kostareg/zenith/docs/v0.1.0.md

## Zenith Architecture v0.1.0

### Summary

Zenith is a 64-bit little-endian CPU coupled with a tile-based tensor accelerator. Instructions are fixed-width 32 bits, it uses a load/store architecture, and has byte-addressable memory. See below for details on registers, instructions, and traps.

### Registers

#### CPU Registers

Zenith CPU has 32 registers. They are almost all general-purpose, but have some conventions as described below. Each are one word (64 bits) and memory is little-endian. 

| zn | name  | description |
|---|---|---|
| z0 | zero  | always zero |
| z1 | ra | return address |
| z2 | sp | stack pointer |
| z3–z10  | a0–a7 | arguments / return values |
| z11–z18 | t0–t7 | caller-saved |
| z19–z26 | s0–s7 | callee-saved |
| z27–z31 | k0–k4 | kernel trap / scratch |

#### TPU Registers

The TPU has 32 registers for the tensor unit, each being 1024 bits. This can store, for example, an 8x8 16-bit tensor.

### Instructions

#### Arithmetic

| Instruction | Description |
|---|---|
| add rd, rs1, rs2 | rd = rs1 + rs2 |
| sub rd, rs1, rs2 | rd = rs1 - rs2 |
| mul rd, rs1, rs2 | rd = rs1 * rs2 |
| div rd, rs1, rs2 | rd = rs1 / rs2[^1] |
| addi rd, rs1, imm | rd = rs1 + imm |
| muli rd, rs1, imm | rd = rs1 * imm |
| divi rd, rs1, imm | rd = rs1 / imm |
| and rd, rs1, rs2 | bitwise and |
| or rd, rs1, rs2 | bitwise or |
| xor rd, rs1, rs2 | bitwise xor |
| not rd, rs1 | bitwise not |
| sll rd, rs1, rs2 | logical left shift |
| srl rd, rs1, rs2 | logical right shift |
| sla rd, rs1, rs2 | arithmetic left shift  |
| sra rd, rs1, rs2 | arithmetic right shift |

[^1]: traps on divide by zero.

Arithmetic overflow is undefined behaviour.
Shift instructions use the low 6 bits of `rs2` as the shift amount. Arithmetic left shift is equivalent to logical
left shift for 64-bit two's-complement values.

#### Memory

| Instruction | Description |
|---|---|
| l8  rd, imm(rs1) | load 8-bit value, sign-extend to 64-bit |
| l16 rd, imm(rs1) | load 16-bit value, sign-extend to 64-bit |
| l32 rd, imm(rs1) | load 32-bit value, sign-extend to 64-bit |
| l64 rd, imm(rs1) | load 64-bit value |
| s8  rs2, imm(rs1)  | store lower 8 bits of rs2 |
| s16 rs2, imm(rs1)  | store lower 16 bits of rs2 |
| s32 rs2, imm(rs1)  | store lower 32 bits of rs2 |
| s64 rs2, imm(rs1)  | store full 64 bits of rs2 |
| tld qd, imm(rs1) | load tensor |
| tsd qs, imm(rs1) | store tensor |

#### Control

| Instruction | Description |
|---|---|
| beq rs1, rs2, off | branch if equal |
| bne rs1, rs2, off | branch if not equal |
| bge rs1, rs2, off | branch if >= |
| ble rs1, rs2, off | branch if <= |
| bgt rs1, rs2, off | branch if > |
| blt rs1, rs2, off | branch if < |
| jal rd, off | rd = next pc; jump |
| jalr rd, rs1, off | rd = next pc; indirect jump |

Branch offsets are signed relative immediate values. Regular execution advances the program counter by 4 bytes (32
bits).

#### Tensor

| Instruction | Description |
|---|---|
| tmatmul qd, qa, qb | qd = qa * qb (matrix-wise) |
| tmul qd, qa, qb | qd = qa * qb (element-wise) |
| tmac qd, qa, qb | qd += qa * qb |
| tadd qd, qa, qb | qd = qa + qb |
| tsub qd, qa, qb | qd = qa - qb |
| tmov qd, qs | copy |
| tfill qd, imm | fill |
| tscale qd, qs, imm | shift / scale |
| tmax rd, qs | max reduction |
| targmax rd, qs | index of max element |
| tsum rd, qs | sum reduction |
| tcast qd, rs | broadcast scalar |
| tsync | sync |

#### System

| Instruction | Description |
|---|---|
| ecall | trap to kernel |
| eret | return from trap |
| halt | stop execution |

#### Instruction Encoding

All Zenith instructions are encoded as 32-bit little-endian words. The low 7 bits select the opcode.

| Bits  | Name | Description |
|---|---|---|
| 0–6 | opcode  | instruction opcode |
| 7–11  | field1  | first register field |
| 12–16 | field2  | second register field |
| 17–21 | field3  | third register field |
| 22–31 | unused  | reserved |

Register-register instructions use `field1` as `rd`, `field2` as `rs1`, and `field3` as `rs2`.

| Bits  | Name |
|---|---|
| 0–6 | opcode |
| 7–11  | rd |
| 12–16 | rs1 |
| 17–21 | rs2 |
| 22–31 | unused |

Unary register instructions use `field1` as `rd`, `field2` as `rs1`, and reserve `field3` and unused bits as zero.

| Bits  | Name |
|---|---|
| 0–6 | opcode |
| 7–11  | rd |
| 12–16 | rs1 |
| 17–21 | reserved |
| 22–31 | reserved |

Register-immediate, load, store, branch, and `jalr` instructions use a 15-bit signed immediate in bits 17–31.

| Bits  | Name |
|---|---|
| 0–6 | opcode |
| 7–11  | rd/rs1/rs2 |
| 12–16 | rs1/rs2 |
| 17–31 | imm15 / off15  |

For arithmetic-immediate and load instructions, `field1` is `rd` and `field2` is `rs1`. For store instructions,
`field1` is `rs2` and `field2` is `rs1`. For branch instructions, `field1` is `rs1`, `field2` is `rs2`, and the
signed offset is relative to the current program counter. For `jalr`, `field1` is `rd`, `field2` is `rs1`, and the
signed offset is relative to `rs1`.

`jal` uses a 20-bit signed offset in bits 12–31.

| Bits  | Name  |
|---|---|
| 0–6 | opcode |
| 7–11  | rd |
| 12–31 | off20 |

Assigned opcodes:

| Opcode | Instruction |
|---|---|
| 0x00 | add |
| 0x01 | sub |
| 0x02 | mul |
| 0x03 | div |
| 0x04 | addi |
| 0x05 | muli |
| 0x06 | divi |
| 0x07 | and |
| 0x08 | or |
| 0x09 | xor |
| 0x0A | l8 |
| 0x0B | l16 |
| 0x0C | l32 |
| 0x0D | l64 |
| 0x0E | s8 |
| 0x0F | s16 |
| 0x10 | s32 |
| 0x11 | s64 |
| 0x14 | beq |
| 0x15 | bne |
| 0x16 | bge |
| 0x17 | ble |
| 0x18 | bgt |
| 0x19 | blt |
| 0x1A | jal |
| 0x1B | jalr |
| 0x1C | not |
| 0x1D | sll |
| 0x1E | srl |
| 0x1F | sla |
| 0x20 | sra |

Tensor and system opcode assignments are reserved for future revisions.

### Modes

For my future reference:

* CPU boots in kernel mode
* Kernel launches programs in user mode
* User cannot access privileged resources directly
* Uses ECALL to request kernel services

### Zelf Executable Format

Zelf is the Zenith executable format. It is a small little-endian binary format with a fixed header, one constant data
section, and one code section.

#### Header

| Offset | Size | Field | Description |
|---|---|---|---|
| 0 | 4 | magic | ASCII bytes `ZELF` |
| 4 | 1 | name_len | program name length, 0 through 8 |
| 5 | 3 | reserved | must be zero |
| 8 | 8 | name | program name, zero-padded ASCII |
| 16 | 8 | data_size | constant data section length, bytes |
| 24 | 8 | code_size | code section length, bytes |
| 32 | 8 | entry_off | entry point offset within the code section |

The header is 40 bytes. `data_size`, `code_size`, and `entry_off` are unsigned 64-bit little-endian values.

The `name` field is a short executable name stored directly in the header. It is not the filesystem path. If `name_len`
is less than 8, all remaining bytes in `name` must be zero.

#### Sections

The constant data section starts immediately after the header. The code section starts immediately after the data
section.

```text
+------------------+
| Zelf header      |
+------------------+
| constant data    |
+------------------+
| code             |
+------------------+
```

The code section contains raw 32-bit Zenith instructions. `code_size` must be a multiple of 4. `entry_off` must be a
multiple of 4 and must be less than `code_size`.

When a Zelf executable is loaded, the kernel copies the constant data and code sections into memory, and starts the
child at `code_base + entry_off`. The exact load addresses are chosen by the kernel.

### System Calls

System calls are requested with `ecall`. The syscall number is passed in `a7`. Arguments are passed in `a0` through
`a5`. Return values are passed in `a0` and `a1`.

`ecall` traps to the kernel. For system calls, the saved exception PC points to the instruction after `ecall`, so a
successful return resumes normal execution at the next instruction.

#### SYS_RUN

`SYS_RUN` loads a Zelf executable from the filesystem, runs it as a child program, and returns to the caller when that
program stops.

| Register | Input |
|---|---|
| a7 | syscall number: `1` |
| a0 | path address |
| a1 | path length, bytes |
| a2 | argument block address |
| a3 | argument block length, bytes |

| Register | Output |
|---|---|
| a0 | child exit code or error code |
| a1 | child trap cause |

The path is an opaque byte string in the caller's memory. It is not null-terminated. If `a1` is zero, the syscall
fails. The kernel copies the path before reading from the filesystem.

The file at the requested path must be a valid Zelf executable. The kernel verifies the Zelf magic number before
starting the child.

The argument block is an opaque byte range in the caller's memory. If `a3` is zero, `a2` is ignored and no arguments
are passed. If `a3` is nonzero, the kernel copies `a3` bytes starting at `a2` before the child starts. The child
receives the copied argument block at an address chosen by the kernel.

`SYS_RUN` is blocking. The caller is suspended while the child runs. When the child stops, the kernel restores the
caller and resumes after the original `ecall`.

The child starts with:

* `pc` set to the child program entry point
* `sp` set to the top of a fresh child stack
* `a0` set to the child argument block address, or zero if no arguments were passed
* `a1` set to the child argument block length
* `a2` set to the constant data section address
* `a3` set to the constant data section length
* all other general-purpose registers set to zero

The child exits normally by executing `halt`. On normal exit, the child's final `a0` value becomes the caller's return
value in `a0`, and the caller's `a1` is set to zero.

If `SYS_RUN` fails before the child starts, the caller resumes immediately with a negative error code in `a0` and zero
in `a1`.

| Error | Meaning |
|---|---|
| -1 | invalid path address or length  |
| -2 | filesystem entry not found |
| -3 | filesystem entry is not a file  |
| -4 | invalid Zelf executable |
| -5 | invalid argument block address  |
| -6 | argument block is too large |
| -7 | insufficient memory |
| -8 | child program could not start |

If the child traps instead of exiting normally, the caller resumes with `a0` set to `-9` and `a1` set to the child trap
cause. Trap cause values are defined by the trap specification.

Unless otherwise specified by the kernel ABI, `SYS_RUN` preserves the caller's registers except for `a0`, `a1`, and
kernel scratch registers.

### Memory Map

Zenith v0.1.0 defines the following physical address map:

| Address range | Region | Description |
|---|---|---|
| `0x0000_0000_0000_0000` - `0x0000_0000_3FFF_FFFF` | RAM | 1 GiB of main memory |
| `0x0000_0000_4000_0000` - `0xFFFF_FFFF_EFFF_FFFF` | reserved | reserved for future use |
| `0xFFFF_FFFF_F000_0000` - `0xFFFF_FFFF_FFFF_FFFF` | MMIO | memory-mapped I/O devices |

Accesses to reserved address ranges trap. MMIO addresses are device-defined and are not normal RAM.

### Framebuffer Controller

The framebuffer peripheral exposes a single-buffered framebuffer. It is located within the MMIO range defined by the
architecture memory map.

All framebuffer registers are little-endian 32-bit MMIO registers.

#### Memory Map

The v0.1.0 framebuffer device uses the following MMIO address ranges:

| Address range | Region | Description |
|---|---|---|
| `0xFFFF_FFFF_FFA0_1400` - `0xFFFF_FFFF_FFA1_13FF` | control | framebuffer control and status registers |
| `0xFFFF_FFFF_FFA1_1400` - `0xFFFF_FFFF_FFFF_FFFF` | pixel buffer  | 1920 x 1080 x 24-bit single framebuffer |

#### Display Format

The framebuffer is a fixed 1920 x 1080 linear image. Each pixel is 24 bits and stored in row-major order.

Pixel byte layout:

| Byte offset | Channel |
|---|---|
| 0 | red |
| 1 | green |
| 2 | blue |

The byte address for a pixel is:

```text
pixel_address = 0xFFFF_FFFF_FFA1_1400 + ((y * 1920) + x) * 3
```

where `x` is in the range 0 through 1919 and `y` is in the range 0 through 1079.

#### Registers

The control region contains a small pixel buffer controller. It exposes the framebuffer resolution and a combined
status/control register. Since this version of the framebuffer is single-buffered, there is no buffer swapping logic.

| Address | Name | Access | Description |
|---|---|---|---|
| `0xFFFF_FFFF_FFA0_1400` | `RESOLUTION` | R | framebuffer width and height |
| `0xFFFF_FFFF_FFA0_1404` | `STATUS_CONTROL` | R/W | display status when read, display control when written |

##### RESOLUTION

| Bits  | Name | Description |
|---|---|---|
| 0-15  | `WIDTH`  | framebuffer width, always 1920 |
| 16-31 | `HEIGHT` | framebuffer height, always 1080 |

##### STATUS_CONTROL

When read, `STATUS_CONTROL` returns display status:

| Bit | Name | Description |
|-----|---|---|
| 0 | `VSYNC`  | set to 1 during the vertical synchronization interval |
| 1 | `ENABLE` | set to 1 when the framebuffer output is enabled |
| 2-31| reserved | read as zero |

When written, `STATUS_CONTROL` updates display control:

| Bit | Name | Description |
|-----|---|---|
| 0 | reserved | must be written as zero |
| 1 | `ENABLE` | write 1 to enable framebuffer output, or 0 to disable it |
| 2-31| reserved | must be written as zero |

Software can poll the `VSYNC` bit to synchronize framebuffer writes with display refresh. The `VSYNC` bit is not
latched; it reflects the current display timing state.

#### Single-Buffered Behavior

The pixel buffer is single-buffered. Writes to the pixel buffer update the only framebuffer image. The display may read
from the same buffer while software is writing to it, so tearing is possible.

Software that wants to reduce tearing should update the framebuffer while the `VSYNC` bit is set.

### Keyboard Controller

The keyboard peripheral exposes a pollable key-event FIFO. Software reads key events from MMIO registers.

The hardware controller is responsible for receiving keyboard protocol data, translating it into key events, and
pushing those events into the FIFO.

All keyboard registers are little-endian 32-bit MMIO registers.

#### Memory Map

The v0.1.0 keyboard device uses the following MMIO address range:

| Address range | Region  | Description |
|---|---|---|
| `0xFFFF_FFFF_FFA0_0000` - `0xFFFF_FFFF_FFA0_0FFF` | control | keyboard control, status, and event registers |

#### Registers

| Address | Name | Access | Description |
|---|---|---|---|
| `0xFFFF_FFFF_FFA0_0000` | `STATUS_CONTROL` | R/W | keyboard status when read, keyboard control when written |
| `0xFFFF_FFFF_FFA0_0004` | `KEY_EVENT` | R | read and pop the oldest pending key event |
| `0xFFFF_FFFF_FFA0_0008` | `FIFO_COUNT` | R | number of pending key events |

##### STATUS_CONTROL

When read, `STATUS_CONTROL` returns keyboard status:

| Bit | Name | Description |
|-----|---|---|
| 0 | `READY` | set to 1 when `KEY_EVENT` can be read |
| 1 | `FULL` | set to 1 when the event FIFO is full |
| 2 | `OVERFLOW` | set to 1 if one or more key events were dropped |
| 3 | `ENABLED`  | set to 1 when the keyboard controller is enabled |
| 4-31| reserved | read as zero |

When written, `STATUS_CONTROL` updates keyboard control:

| Bit | Name | Description |
|-----|---|---|
| 0 | reserved | must be written as zero |
| 1 | reserved | must be written as zero |
| 2 | `CLR_OVER` | write 1 to clear `OVERFLOW` |
| 3 | `ENABLE` | write 1 to enable the keyboard controller, or 0 to disable it |
| 4 | `CLR_FIFO` | write 1 to discard all pending key events |
| 5-31| reserved | must be written as zero |

Disabling the keyboard controller stops new events from being pushed into the FIFO. It does not clear pending events
unless `CLR_FIFO` is also written.

##### KEY_EVENT

Reading `KEY_EVENT` returns and removes the oldest pending event from the FIFO. If `READY` is zero, reading `KEY_EVENT`
returns zero and does not change controller state.

| Bits  | Name | Description |
|---|---|---|
| 0-15  | `KEY_CODE` | key code |
| 16 | `PRESSED`  | 1 for key press, 0 for key release |
| 17 | `REPEAT` | 1 if the event is an auto-repeat key press |
| 18-31 | reserved | read as zero |

Key codes are USB HID Keyboard/Keypad usage IDs. For example, `0x04` is `A`, `0x05` is `B`, `0x1E` is `1`, `0x28` is
Enter, and `0x2C` is Space.

##### FIFO_COUNT

`FIFO_COUNT` returns the number of pending key events in the FIFO. The v0.1.0 FIFO depth is 16 events.

#### Polling

Software can poll for keyboard input by repeatedly reading `STATUS_CONTROL`. When `READY` is set, software reads
`KEY_EVENT` to consume the next key event.

```text
status = load32(0xFFFF_FFFF_FFA0_0000)
if status & 1:
    event = load32(0xFFFF_FFFF_FFA0_0004)
```
