kostareg/zenith/zenith-pcba/imports/K4B4G1646E-BCNB/BGA96_K4B4G1_SAM.step

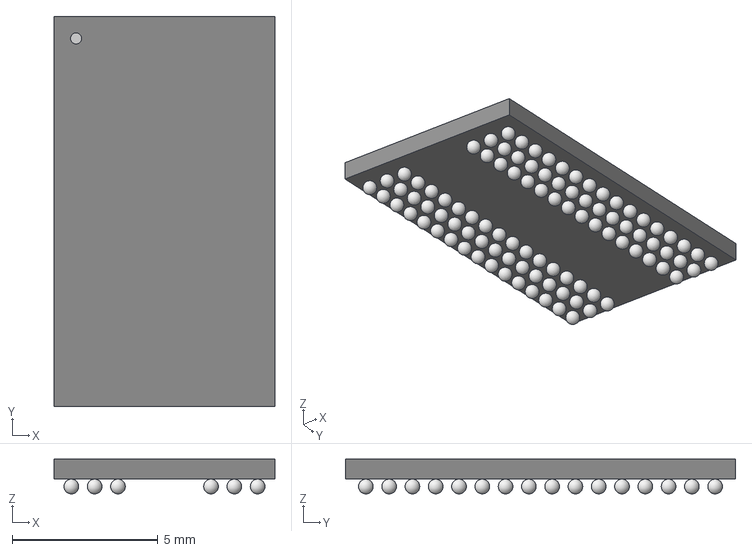
[picture p1: CAD file, 2026-07-13]
zenith-pcba/imports/K4B4G1646E-BCNB/BGA96_K4B4G1_SAM.step
7.59 x 13.4 x 1.20 mm
