kostareg/zenith/zenith-pcba/imports/XC7A50T-2CSG325C/CSCSG325_AMD.step

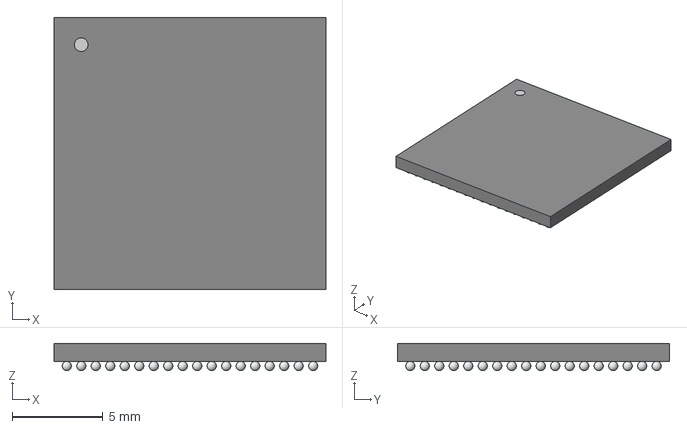
[picture p2: CAD file, 2026-07-13]
zenith-pcba/imports/XC7A50T-2CSG325C/CSCSG325_AMD.step
15.0 x 15.0 x 1.50 mm
