kostareg/zenith/zenith-pcba/zenith-pcba.kicad_pcb

## KiCad design zenith-pcba/zenith-pcba.kicad_pcb (2026-08-18)

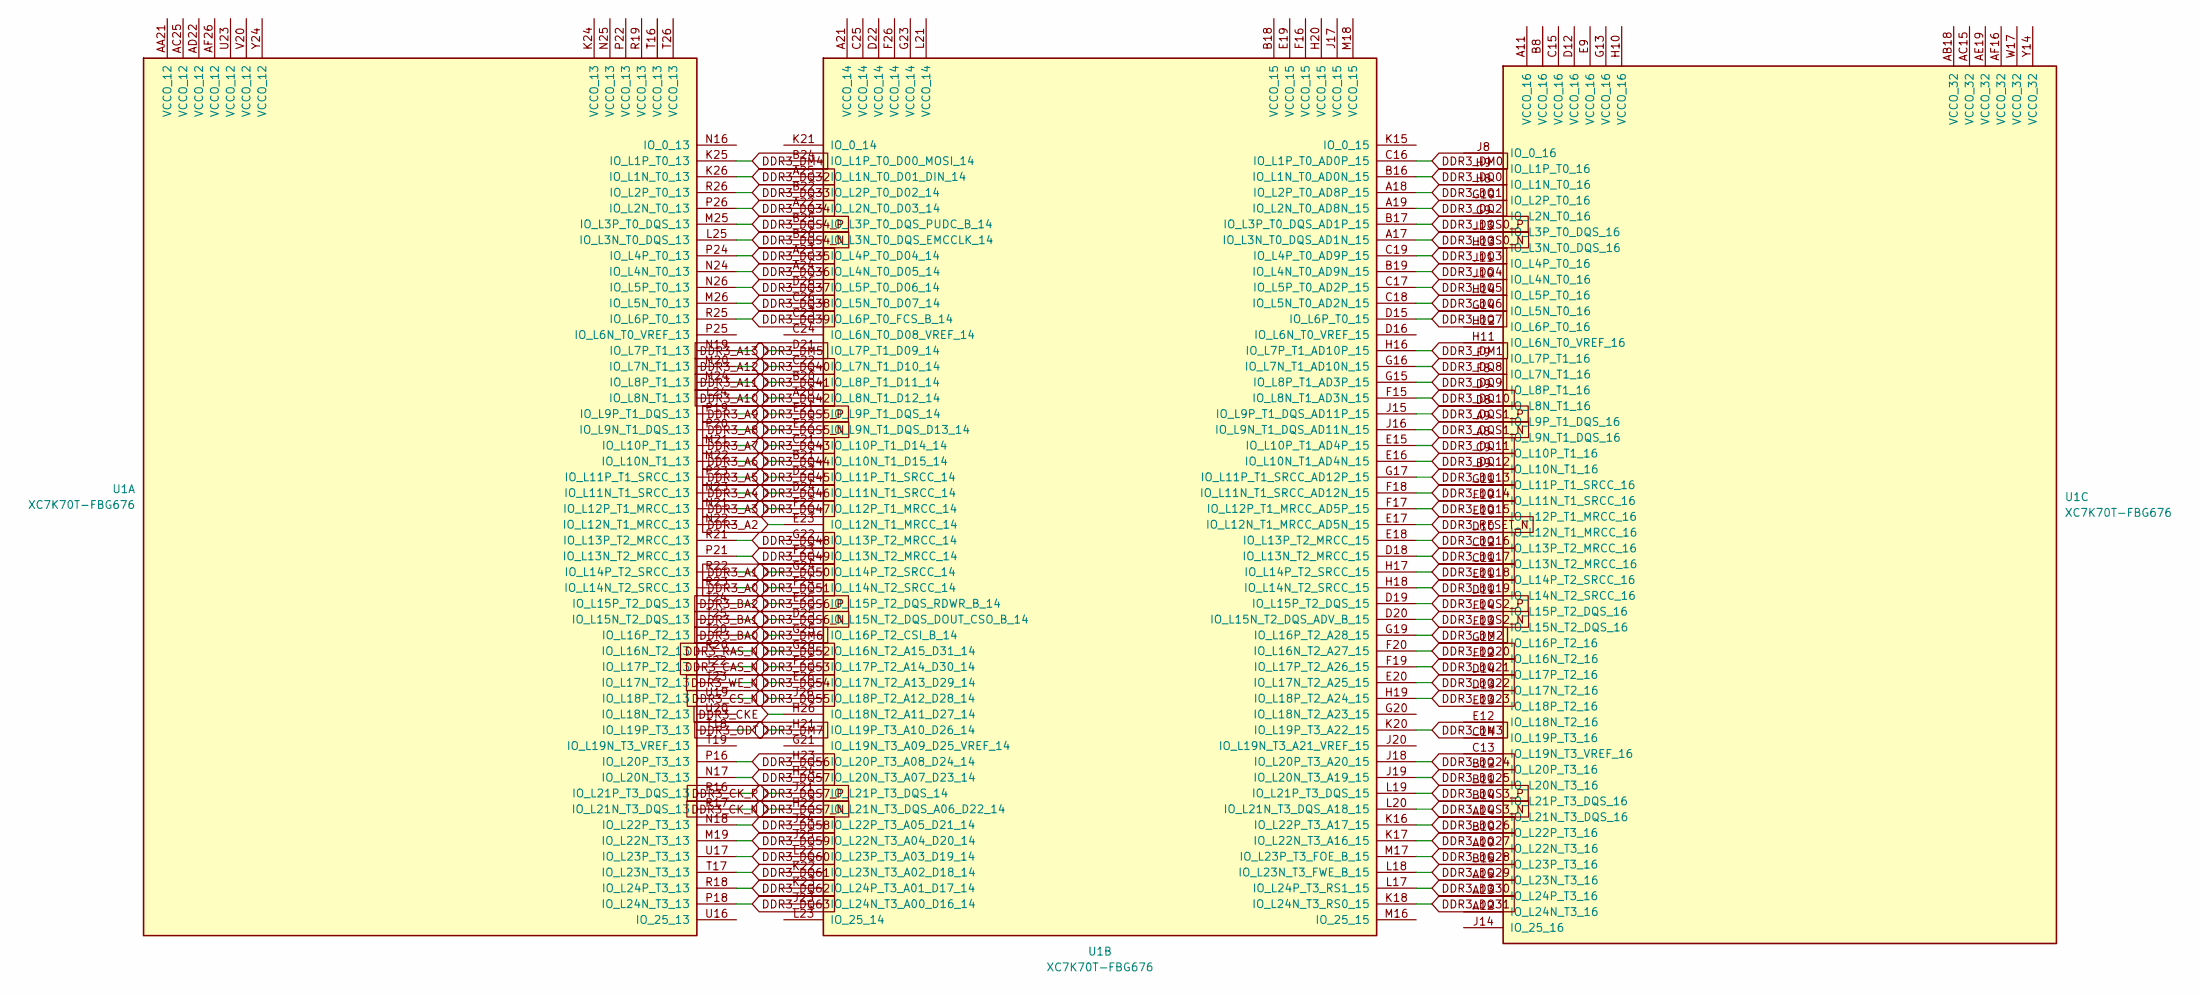
[picture p3: schematic disconnected_io.kicad_sch]

Parts:
U1: XC7K70T-FBG676; FBGA-676_L27.0-W27.0-R26-C26-P1.00-BL

Connections:
DDR3_A0: U1.F24 (IO_L14N_T2_SRCC_14); also elsewhere on the board
DDR3_A1: U1.G24 (IO_L14P_T2_SRCC_14); also elsewhere on the board
DDR3_A2: U1.E23 (IO_L12N_T1_MRCC_14); also elsewhere on the board
DDR3_A3: U1.F22 (IO_L12P_T1_MRCC_14); also elsewhere on the board
DDR3_A4: U1.D24 (IO_L11N_T1_SRCC_14); also elsewhere on the board
DDR3_A5: U1.D23 (IO_L11P_T1_SRCC_14); also elsewhere on the board
DDR3_A6: U1.B21 (IO_L10N_T1_D15_14); also elsewhere on the board
DDR3_A7: U1.C21 (IO_L10P_T1_D14_14); also elsewhere on the board
DDR3_A8: U1.E22 (IO_L9N_T1_DQS_D13_14); also elsewhere on the board
DDR3_A9: U1.E21 (IO_L9P_T1_DQS_14); also elsewhere on the board
DDR3_A10: U1.A20 (IO_L8N_T1_D12_14); also elsewhere on the board
DDR3_A11: U1.B20 (IO_L8P_T1_D11_14); also elsewhere on the board
DDR3_A12: U1.C22 (IO_L7N_T1_D10_14); also elsewhere on the board
DDR3_A13: U1.D21 (IO_L7P_T1_D09_14); also elsewhere on the board
DDR3_BA0: U1.G25 (IO_L16P_T2_CSI_B_14); also elsewhere on the board
DDR3_BA1: U1.D25 (IO_L15N_T2_DQS_DOUT_CSO_B_14); also elsewhere on the board
DDR3_BA2: U1.E25 (IO_L15P_T2_DQS_RDWR_B_14); also elsewhere on the board
DDR3_CAS_N: U1.F25 (IO_L17P_T2_A14_D30_14); also elsewhere on the board
DDR3_CKE: U1.H26 (IO_L18N_T2_A11_D27_14); also elsewhere on the board
DDR3_CK_N: U1.H22 (IO_L21N_T3_DQS_A06_D22_14); also elsewhere on the board
DDR3_CK_P: U1.J21 (IO_L21P_T3_DQS_14); also elsewhere on the board
DDR3_CS_N: U1.J26 (IO_L18P_T2_A12_D28_14); also elsewhere on the board
DDR3_DM0: U1.C16 (IO_L1P_T0_AD0P_15); also elsewhere on the board
DDR3_DM1: U1.H16 (IO_L7P_T1_AD10P_15); also elsewhere on the board
DDR3_DM2: U1.G19 (IO_L16P_T2_A28_15); also elsewhere on the board
DDR3_DM3: U1.K20 (IO_L19P_T3_A22_15); also elsewhere on the board
DDR3_DM4: U1.K25 (IO_L1P_T0_13); also elsewhere on the board
DDR3_DM5: U1.N19 (IO_L7P_T1_13); also elsewhere on the board
DDR3_DM6: U1.T20 (IO_L16P_T2_13); also elsewhere on the board
DDR3_DM7: U1.T18 (IO_L19P_T3_13); also elsewhere on the board
DDR3_DQ0: U1.B16 (IO_L1N_T0_AD0N_15); also elsewhere on the board
DDR3_DQ1: U1.A18 (IO_L2P_T0_AD8P_15); also elsewhere on the board
DDR3_DQ2: U1.A19 (IO_L2N_T0_AD8N_15); also elsewhere on the board
DDR3_DQ3: U1.C19 (IO_L4P_T0_AD9P_15); also elsewhere on the board
DDR3_DQ4: U1.B19 (IO_L4N_T0_AD9N_15); also elsewhere on the board
DDR3_DQ5: U1.C17 (IO_L5P_T0_AD2P_15); also elsewhere on the board
DDR3_DQ6: U1.C18 (IO_L5N_T0_AD2N_15); also elsewhere on the board
DDR3_DQ7: U1.D15 (IO_L6P_T0_15); also elsewhere on the board
DDR3_DQ8: U1.G16 (IO_L7N_T1_AD10N_15); also elsewhere on the board
DDR3_DQ9: U1.G15 (IO_L8P_T1_AD3P_15); also elsewhere on the board
DDR3_DQ10: U1.F15 (IO_L8N_T1_AD3N_15); also elsewhere on the board
DDR3_DQ11: U1.E15 (IO_L10P_T1_AD4P_15); also elsewhere on the board
DDR3_DQ12: U1.E16 (IO_L10N_T1_AD4N_15); also elsewhere on the board
DDR3_DQ13: U1.G17 (IO_L11P_T1_SRCC_AD12P_15); also elsewhere on the board
DDR3_DQ14: U1.F18 (IO_L11N_T1_SRCC_AD12N_15); also elsewhere on the board
DDR3_DQ15: U1.F17 (IO_L12P_T1_MRCC_AD5P_15); also elsewhere on the board
DDR3_DQ16: U1.E18 (IO_L13P_T2_MRCC_15); also elsewhere on the board
DDR3_DQ17: U1.D18 (IO_L13N_T2_MRCC_15); also elsewhere on the board
DDR3_DQ18: U1.H17 (IO_L14P_T2_SRCC_15); also elsewhere on the board
DDR3_DQ19: U1.H18 (IO_L14N_T2_SRCC_15); also elsewhere on the board
DDR3_DQ20: U1.F20 (IO_L16N_T2_A27_15); also elsewhere on the board
DDR3_DQ21: U1.F19 (IO_L17P_T2_A26_15); also elsewhere on the board
DDR3_DQ22: U1.E20 (IO_L17N_T2_A25_15); also elsewhere on the board
DDR3_DQ23: U1.H19 (IO_L18P_T2_A24_15); also elsewhere on the board
DDR3_DQ24: U1.J18 (IO_L20P_T3_A20_15); also elsewhere on the board
DDR3_DQ25: U1.J19 (IO_L20N_T3_A19_15); also elsewhere on the board
DDR3_DQ26: U1.K16 (IO_L22P_T3_A17_15); also elsewhere on the board
DDR3_DQ27: U1.K17 (IO_L22N_T3_A16_15); also elsewhere on the board
DDR3_DQ28: U1.M17 (IO_L23P_T3_FOE_B_15); also elsewhere on the board
DDR3_DQ29: U1.L18 (IO_L23N_T3_FWE_B_15); also elsewhere on the board
DDR3_DQ30: U1.L17 (IO_L24P_T3_RS1_15); also elsewhere on the board
DDR3_DQ31: U1.K18 (IO_L24N_T3_RS0_15); also elsewhere on the board
DDR3_DQ32: U1.K26 (IO_L1N_T0_13); also elsewhere on the board
DDR3_DQ33: U1.R26 (IO_L2P_T0_13); also elsewhere on the board
DDR3_DQ34: U1.P26 (IO_L2N_T0_13); also elsewhere on the board
DDR3_DQ35: U1.P24 (IO_L4P_T0_13); also elsewhere on the board
DDR3_DQ36: U1.N24 (IO_L4N_T0_13); also elsewhere on the board
DDR3_DQ37: U1.N26 (IO_L5P_T0_13); also elsewhere on the board
DDR3_DQ38: U1.M26 (IO_L5N_T0_13); also elsewhere on the board
DDR3_DQ39: U1.R25 (IO_L6P_T0_13); also elsewhere on the board
DDR3_DQ40: U1.M20 (IO_L7N_T1_13); also elsewhere on the board
DDR3_DQ41: U1.M24 (IO_L8P_T1_13); also elsewhere on the board
DDR3_DQ42: U1.L24 (IO_L8N_T1_13); also elsewhere on the board
DDR3_DQ43: U1.M21 (IO_L10P_T1_13); also elsewhere on the board
DDR3_DQ44: U1.M22 (IO_L10N_T1_13); also elsewhere on the board
DDR3_DQ45: U1.P23 (IO_L11P_T1_SRCC_13); also elsewhere on the board
DDR3_DQ46: U1.N23 (IO_L11N_T1_SRCC_13); also elsewhere on the board
DDR3_DQ47: U1.N21 (IO_L12P_T1_MRCC_13); also elsewhere on the board
DDR3_DQ48: U1.R21 (IO_L13P_T2_MRCC_13); also elsewhere on the board
DDR3_DQ49: U1.P21 (IO_L13N_T2_MRCC_13); also elsewhere on the board
DDR3_DQ50: U1.R22 (IO_L14P_T2_SRCC_13); also elsewhere on the board
DDR3_DQ51: U1.R23 (IO_L14N_T2_SRCC_13); also elsewhere on the board
DDR3_DQ52: U1.R20 (IO_L16N_T2_13); also elsewhere on the board
DDR3_DQ53: U1.T22 (IO_L17P_T2_13); also elsewhere on the board
DDR3_DQ54: U1.T23 (IO_L17N_T2_13); also elsewhere on the board
DDR3_DQ55: U1.U19 (IO_L18P_T2_13); also elsewhere on the board
DDR3_DQ56: U1.P16 (IO_L20P_T3_13); also elsewhere on the board
DDR3_DQ57: U1.N17 (IO_L20N_T3_13); also elsewhere on the board
DDR3_DQ58: U1.N18 (IO_L22P_T3_13); also elsewhere on the board
DDR3_DQ59: U1.M19 (IO_L22N_T3_13); also elsewhere on the board
DDR3_DQ60: U1.U17 (IO_L23P_T3_13); also elsewhere on the board
DDR3_DQ61: U1.T17 (IO_L23N_T3_13); also elsewhere on the board
DDR3_DQ62: U1.R18 (IO_L24P_T3_13); also elsewhere on the board
DDR3_DQ63: U1.P18 (IO_L24N_T3_13); also elsewhere on the board
DDR3_DQS0_N: U1.A17 (IO_L3N_T0_DQS_AD1N_15); also elsewhere on the board
DDR3_DQS0_P: U1.B17 (IO_L3P_T0_DQS_AD1P_15); also elsewhere on the board
DDR3_DQS1_N: U1.J16 (IO_L9N_T1_DQS_AD11N_15); also elsewhere on the board
DDR3_DQS1_P: U1.J15 (IO_L9P_T1_DQS_AD11P_15); also elsewhere on the board
DDR3_DQS2_N: U1.D20 (IO_L15N_T2_DQS_ADV_B_15); also elsewhere on the board
DDR3_DQS2_P: U1.D19 (IO_L15P_T2_DQS_15); also elsewhere on the board
DDR3_DQS3_N: U1.L20 (IO_L21N_T3_DQS_A18_15); also elsewhere on the board
DDR3_DQS3_P: U1.L19 (IO_L21P_T3_DQS_15); also elsewhere on the board
DDR3_DQS4_N: U1.L25 (IO_L3N_T0_DQS_13); also elsewhere on the board
DDR3_DQS4_P: U1.M25 (IO_L3P_T0_DQS_13); also elsewhere on the board
DDR3_DQS5_N: U1.P20 (IO_L9N_T1_DQS_13); also elsewhere on the board
DDR3_DQS5_P: U1.P19 (IO_L9P_T1_DQS_13); also elsewhere on the board
DDR3_DQS6_N: U1.T25 (IO_L15N_T2_DQS_13); also elsewhere on the board
DDR3_DQS6_P: U1.T24 (IO_L15P_T2_DQS_13); also elsewhere on the board
DDR3_DQS7_N: U1.R17 (IO_L21N_T3_DQS_13); also elsewhere on the board
DDR3_DQS7_P: U1.R16 (IO_L21P_T3_DQS_13); also elsewhere on the board
DDR3_ODT: U1.H21 (IO_L19P_T3_A10_D26_14); also elsewhere on the board
DDR3_RAS_N: U1.G26 (IO_L16N_T2_A15_D31_14); also elsewhere on the board
DDR3_RESET_N: U1.E17 (IO_L12N_T1_MRCC_AD5N_15); also elsewhere on the board
DDR3_WE_N: U1.E26 (IO_L17N_T2_A13_D29_14); also elsewhere on the board

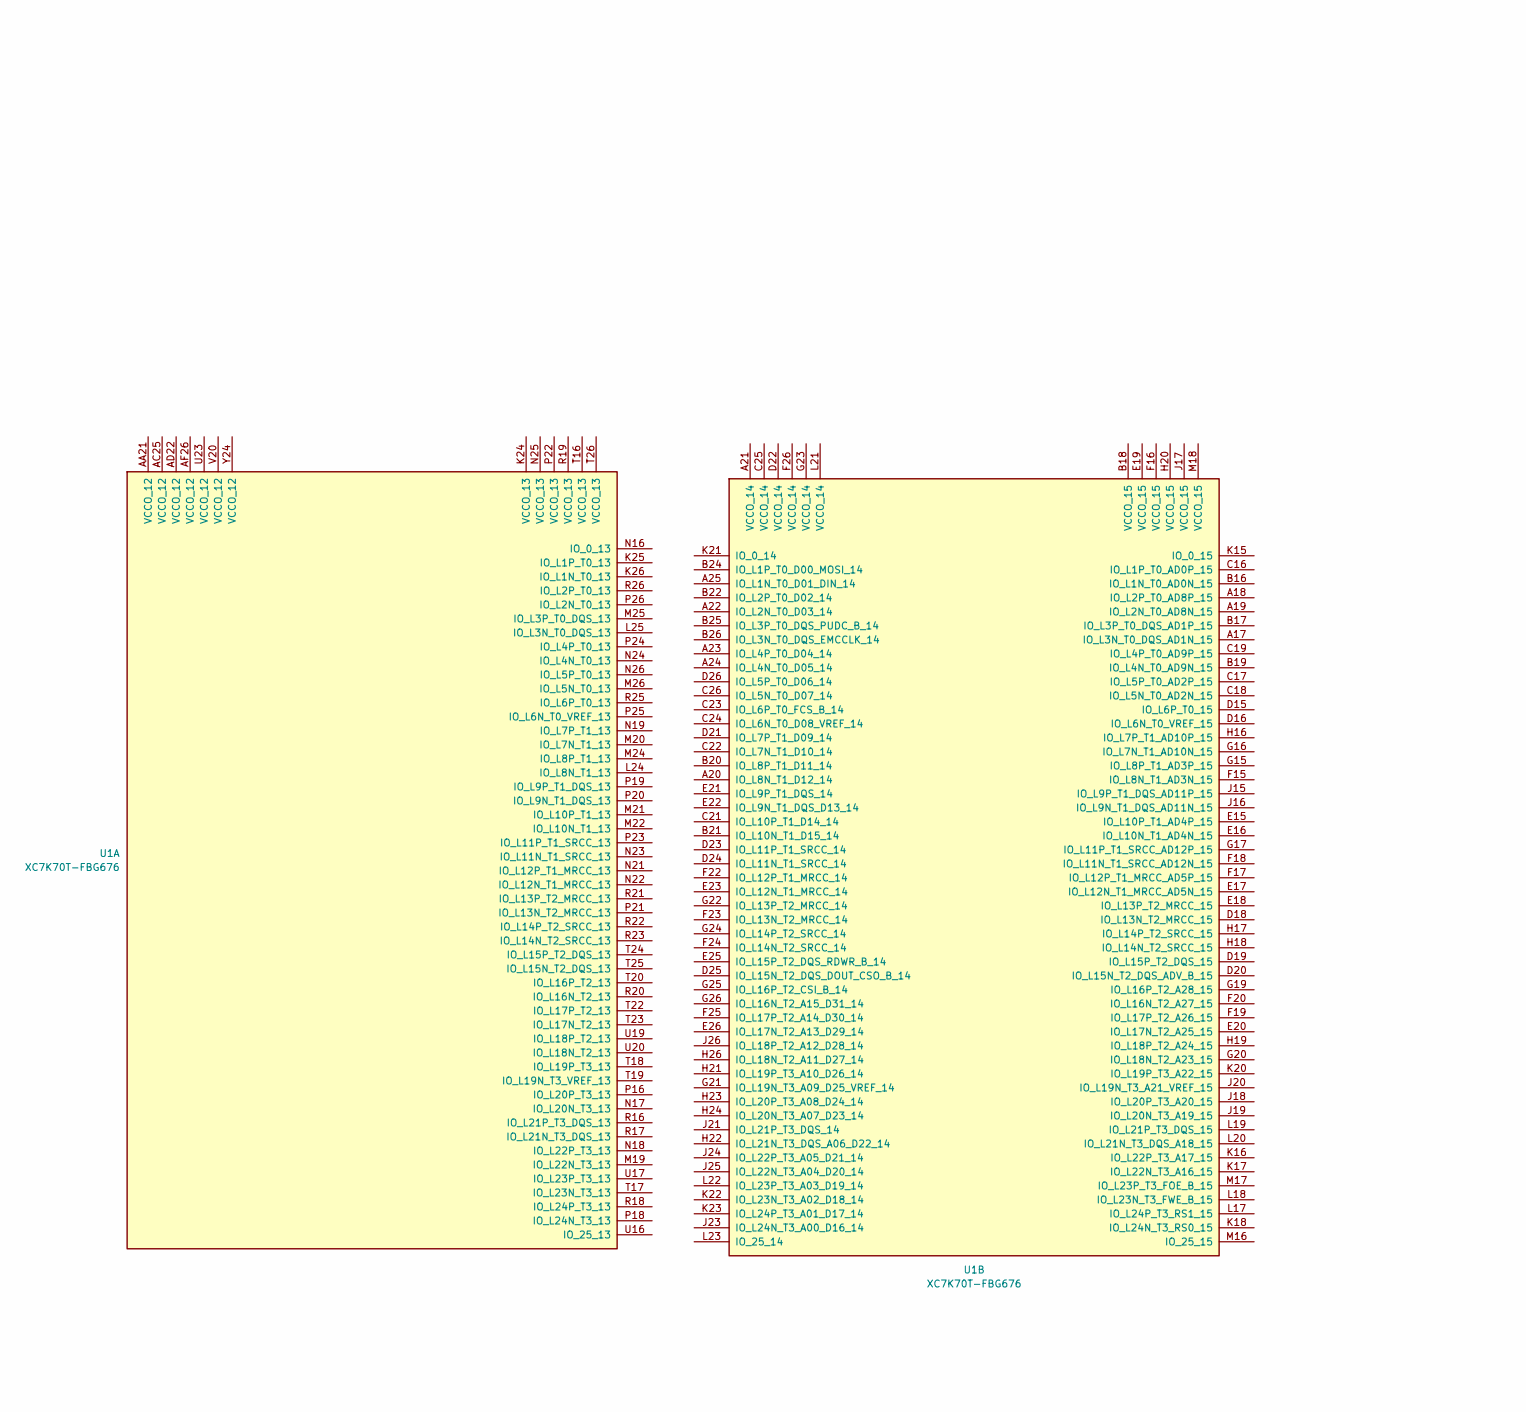
[picture p4: schematic other.kicad_sch, part in row 1, column 1]

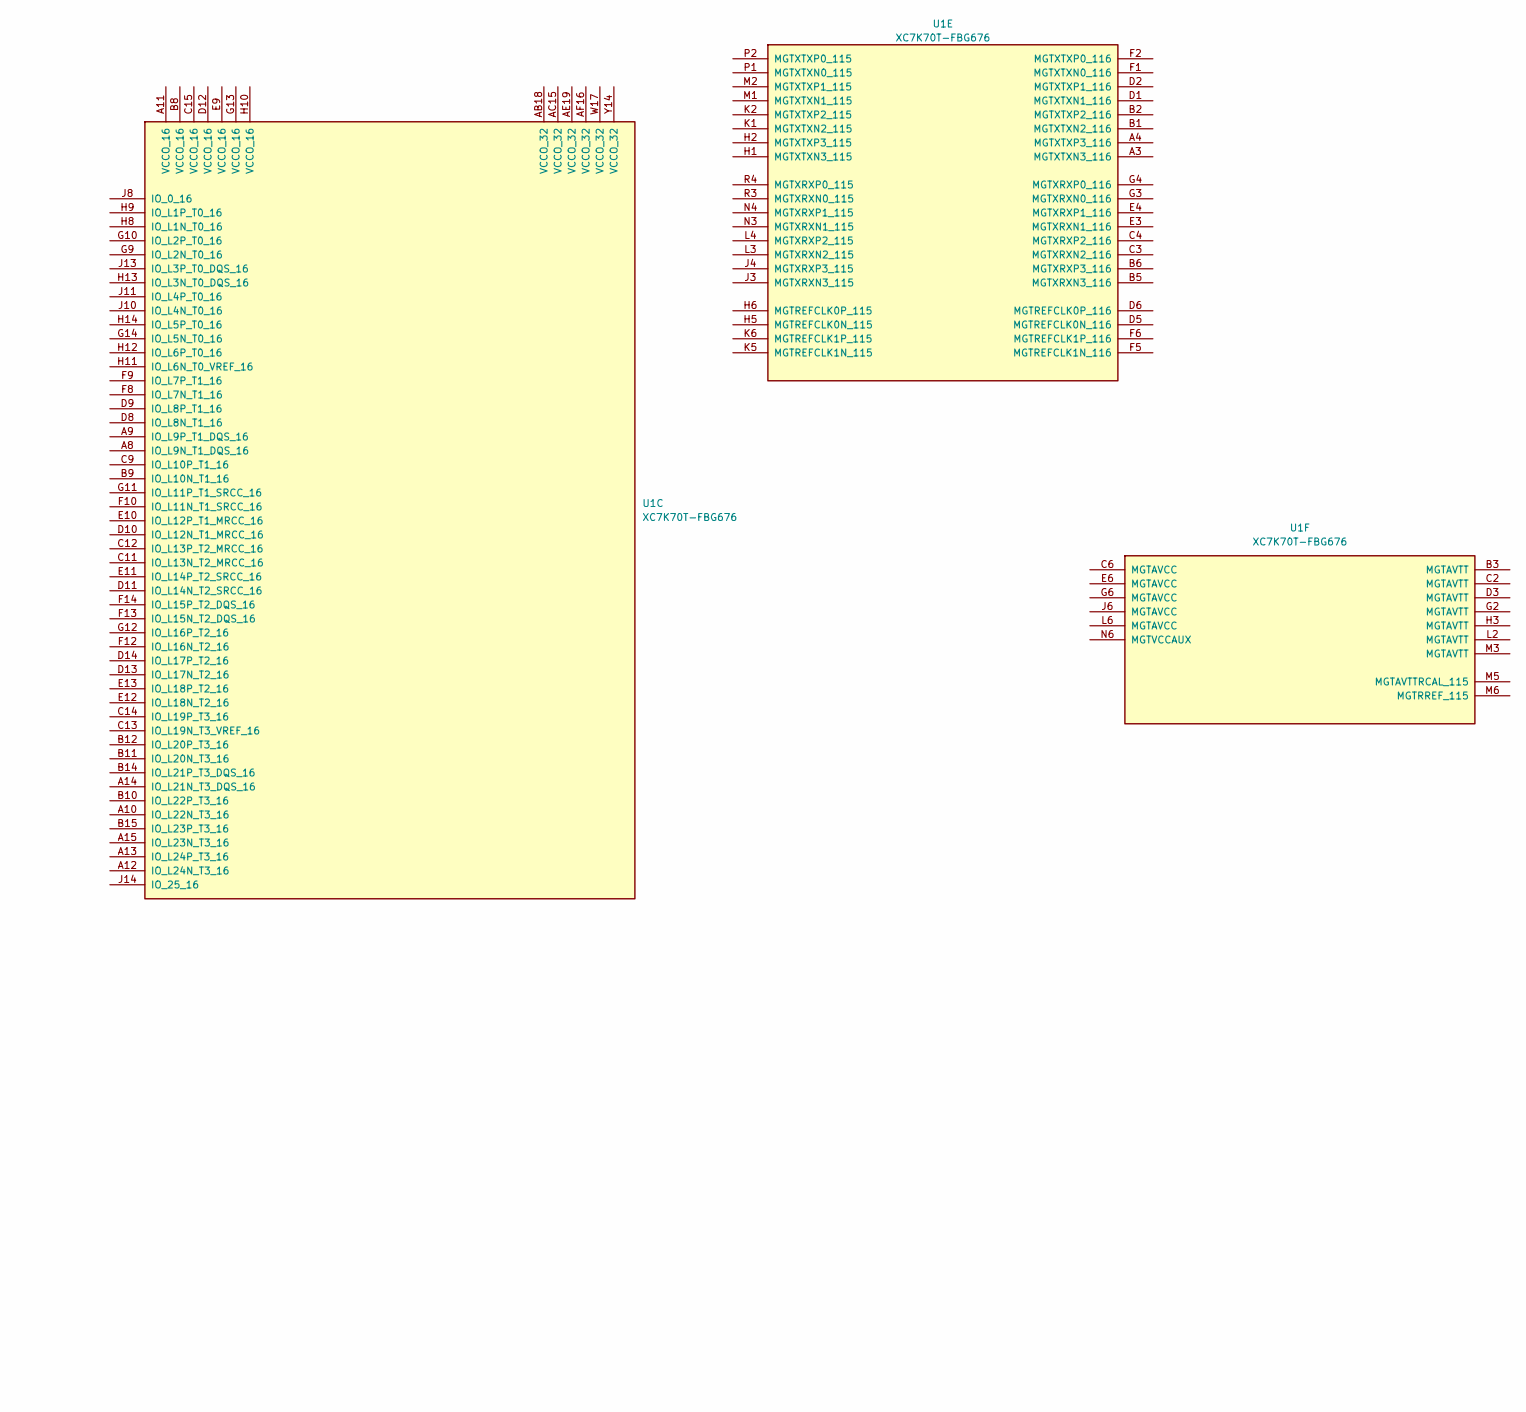
[picture p5: schematic other.kicad_sch, part in row 1, column 2]

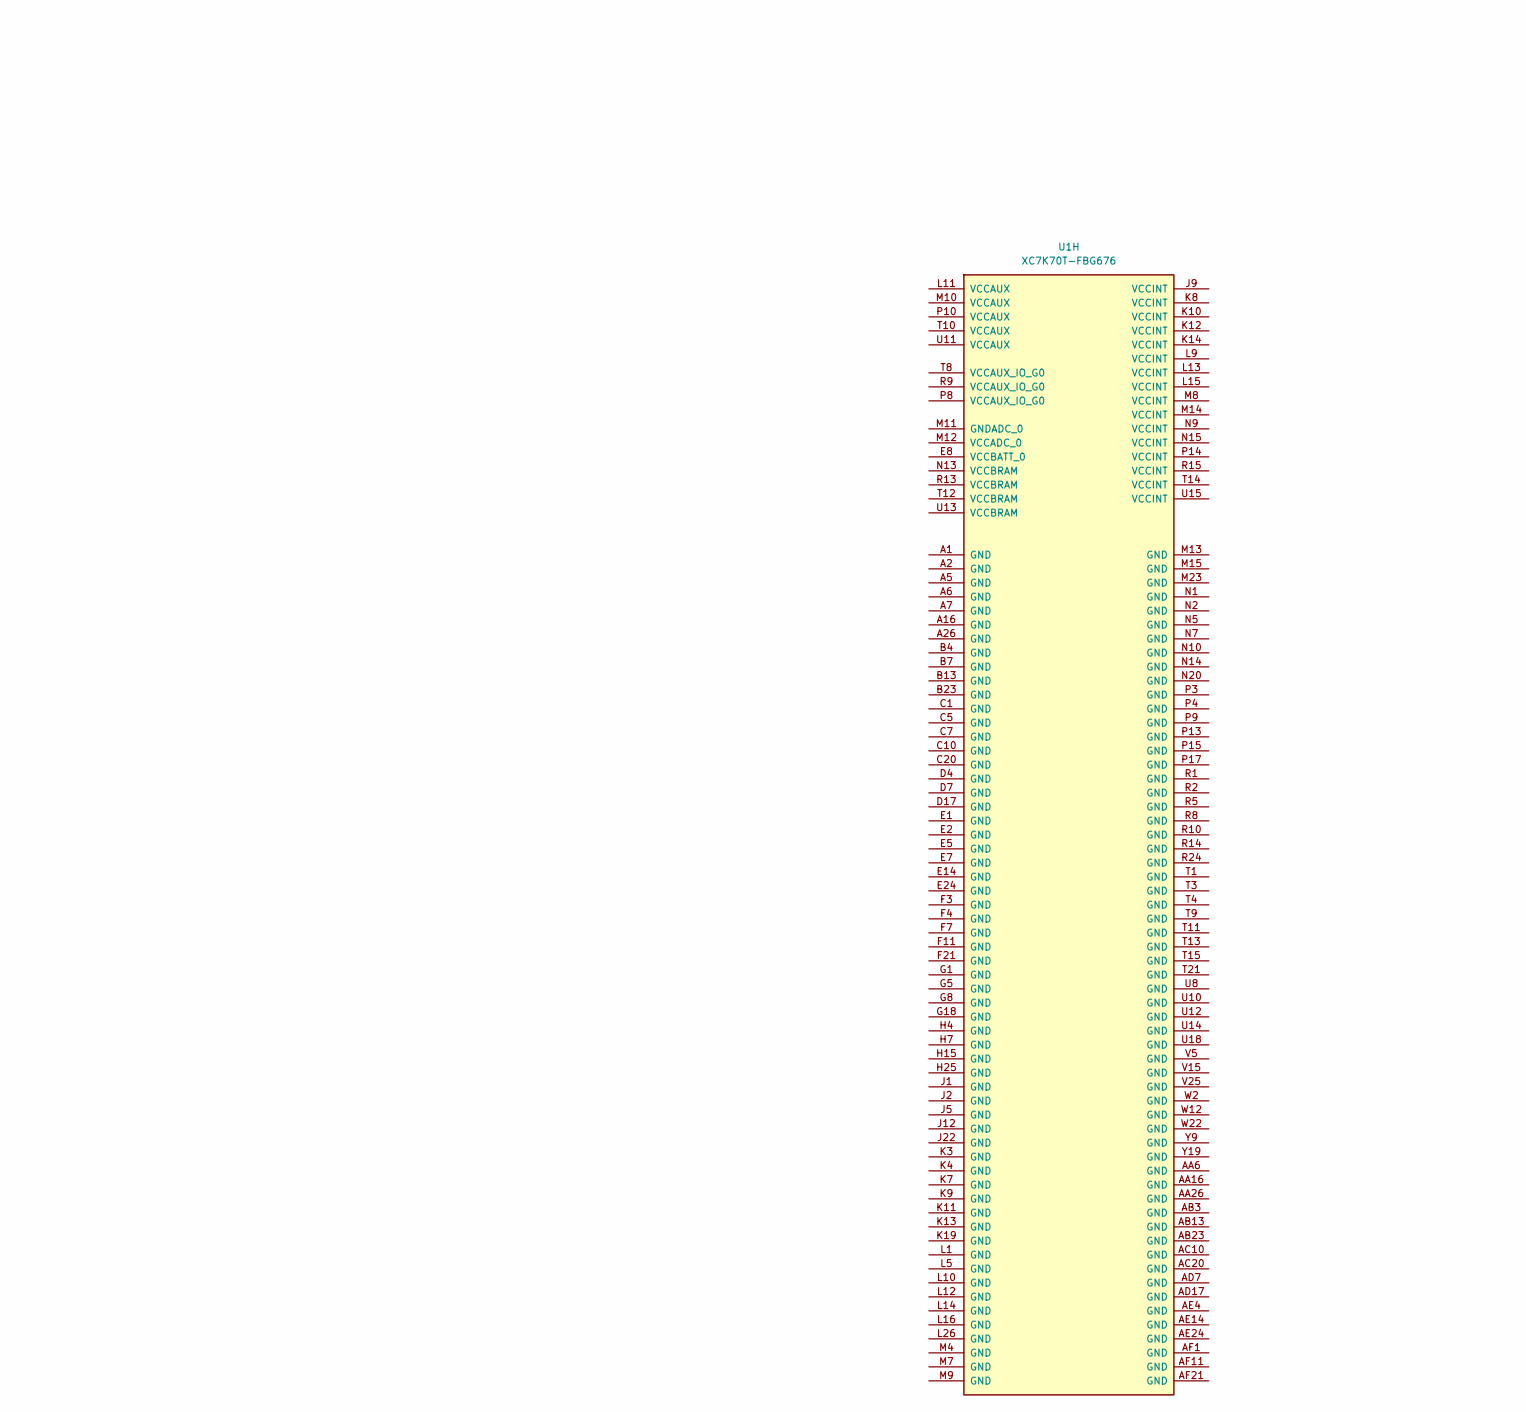
[picture p6: schematic other.kicad_sch, part in row 2, column 2]

Parts:
U1: XC7K70T-FBG676; FBGA-676_L27.0-W27.0-R26-C26-P1.00-BL

Connections:
DDR3_A0: U1.F24 (IO_L14N_T2_SRCC_14); also elsewhere on the board
DDR3_A1: U1.G24 (IO_L14P_T2_SRCC_14); also elsewhere on the board
DDR3_A2: U1.E23 (IO_L12N_T1_MRCC_14); also elsewhere on the board
DDR3_A3: U1.F22 (IO_L12P_T1_MRCC_14); also elsewhere on the board
DDR3_A4: U1.D24 (IO_L11N_T1_SRCC_14); also elsewhere on the board
DDR3_A5: U1.D23 (IO_L11P_T1_SRCC_14); also elsewhere on the board
DDR3_A6: U1.B21 (IO_L10N_T1_D15_14); also elsewhere on the board
DDR3_A7: U1.C21 (IO_L10P_T1_D14_14); also elsewhere on the board
DDR3_A8: U1.E22 (IO_L9N_T1_DQS_D13_14); also elsewhere on the board
DDR3_A9: U1.E21 (IO_L9P_T1_DQS_14); also elsewhere on the board
DDR3_A10: U1.A20 (IO_L8N_T1_D12_14); also elsewhere on the board
DDR3_A11: U1.B20 (IO_L8P_T1_D11_14); also elsewhere on the board
DDR3_A12: U1.C22 (IO_L7N_T1_D10_14); also elsewhere on the board
DDR3_A13: U1.D21 (IO_L7P_T1_D09_14); also elsewhere on the board
DDR3_BA0: U1.G25 (IO_L16P_T2_CSI_B_14); also elsewhere on the board
DDR3_BA1: U1.D25 (IO_L15N_T2_DQS_DOUT_CSO_B_14); also elsewhere on the board
DDR3_BA2: U1.E25 (IO_L15P_T2_DQS_RDWR_B_14); also elsewhere on the board
DDR3_CAS_N: U1.F25 (IO_L17P_T2_A14_D30_14); also elsewhere on the board
DDR3_CKE: U1.H26 (IO_L18N_T2_A11_D27_14); also elsewhere on the board
DDR3_CK_N: U1.H22 (IO_L21N_T3_DQS_A06_D22_14); also elsewhere on the board
DDR3_CK_P: U1.J21 (IO_L21P_T3_DQS_14); also elsewhere on the board
DDR3_CS_N: U1.J26 (IO_L18P_T2_A12_D28_14); also elsewhere on the board
DDR3_DM0: U1.C16 (IO_L1P_T0_AD0P_15); also elsewhere on the board
DDR3_DM1: U1.H16 (IO_L7P_T1_AD10P_15); also elsewhere on the board
DDR3_DM2: U1.G19 (IO_L16P_T2_A28_15); also elsewhere on the board
DDR3_DM3: U1.K20 (IO_L19P_T3_A22_15); also elsewhere on the board
DDR3_DM4: U1.K25 (IO_L1P_T0_13); also elsewhere on the board
DDR3_DM5: U1.N19 (IO_L7P_T1_13); also elsewhere on the board
DDR3_DM6: U1.T20 (IO_L16P_T2_13); also elsewhere on the board
DDR3_DM7: U1.T18 (IO_L19P_T3_13); also elsewhere on the board
DDR3_DQ0: U1.B16 (IO_L1N_T0_AD0N_15); also elsewhere on the board
DDR3_DQ1: U1.A18 (IO_L2P_T0_AD8P_15); also elsewhere on the board
DDR3_DQ2: U1.A19 (IO_L2N_T0_AD8N_15); also elsewhere on the board
DDR3_DQ3: U1.C19 (IO_L4P_T0_AD9P_15); also elsewhere on the board
DDR3_DQ4: U1.B19 (IO_L4N_T0_AD9N_15); also elsewhere on the board
DDR3_DQ5: U1.C17 (IO_L5P_T0_AD2P_15); also elsewhere on the board
DDR3_DQ6: U1.C18 (IO_L5N_T0_AD2N_15); also elsewhere on the board
DDR3_DQ7: U1.D15 (IO_L6P_T0_15); also elsewhere on the board
DDR3_DQ8: U1.G16 (IO_L7N_T1_AD10N_15); also elsewhere on the board
DDR3_DQ9: U1.G15 (IO_L8P_T1_AD3P_15); also elsewhere on the board
DDR3_DQ10: U1.F15 (IO_L8N_T1_AD3N_15); also elsewhere on the board
DDR3_DQ11: U1.E15 (IO_L10P_T1_AD4P_15); also elsewhere on the board
DDR3_DQ12: U1.E16 (IO_L10N_T1_AD4N_15); also elsewhere on the board
DDR3_DQ13: U1.G17 (IO_L11P_T1_SRCC_AD12P_15); also elsewhere on the board
DDR3_DQ14: U1.F18 (IO_L11N_T1_SRCC_AD12N_15); also elsewhere on the board
DDR3_DQ15: U1.F17 (IO_L12P_T1_MRCC_AD5P_15); also elsewhere on the board
DDR3_DQ16: U1.E18 (IO_L13P_T2_MRCC_15); also elsewhere on the board
DDR3_DQ17: U1.D18 (IO_L13N_T2_MRCC_15); also elsewhere on the board
DDR3_DQ18: U1.H17 (IO_L14P_T2_SRCC_15); also elsewhere on the board
DDR3_DQ19: U1.H18 (IO_L14N_T2_SRCC_15); also elsewhere on the board
DDR3_DQ20: U1.F20 (IO_L16N_T2_A27_15); also elsewhere on the board
DDR3_DQ21: U1.F19 (IO_L17P_T2_A26_15); also elsewhere on the board
DDR3_DQ22: U1.E20 (IO_L17N_T2_A25_15); also elsewhere on the board
DDR3_DQ23: U1.H19 (IO_L18P_T2_A24_15); also elsewhere on the board
DDR3_DQ24: U1.J18 (IO_L20P_T3_A20_15); also elsewhere on the board
DDR3_DQ25: U1.J19 (IO_L20N_T3_A19_15); also elsewhere on the board
DDR3_DQ26: U1.K16 (IO_L22P_T3_A17_15); also elsewhere on the board
DDR3_DQ27: U1.K17 (IO_L22N_T3_A16_15); also elsewhere on the board
DDR3_DQ28: U1.M17 (IO_L23P_T3_FOE_B_15); also elsewhere on the board
DDR3_DQ29: U1.L18 (IO_L23N_T3_FWE_B_15); also elsewhere on the board
DDR3_DQ30: U1.L17 (IO_L24P_T3_RS1_15); also elsewhere on the board
DDR3_DQ31: U1.K18 (IO_L24N_T3_RS0_15); also elsewhere on the board
DDR3_DQ32: U1.K26 (IO_L1N_T0_13); also elsewhere on the board
DDR3_DQ33: U1.R26 (IO_L2P_T0_13); also elsewhere on the board
DDR3_DQ34: U1.P26 (IO_L2N_T0_13); also elsewhere on the board
DDR3_DQ35: U1.P24 (IO_L4P_T0_13); also elsewhere on the board
DDR3_DQ36: U1.N24 (IO_L4N_T0_13); also elsewhere on the board
DDR3_DQ37: U1.N26 (IO_L5P_T0_13); also elsewhere on the board
DDR3_DQ38: U1.M26 (IO_L5N_T0_13); also elsewhere on the board
DDR3_DQ39: U1.R25 (IO_L6P_T0_13); also elsewhere on the board
DDR3_DQ40: U1.M20 (IO_L7N_T1_13); also elsewhere on the board
DDR3_DQ41: U1.M24 (IO_L8P_T1_13); also elsewhere on the board
DDR3_DQ42: U1.L24 (IO_L8N_T1_13); also elsewhere on the board
DDR3_DQ43: U1.M21 (IO_L10P_T1_13); also elsewhere on the board
DDR3_DQ44: U1.M22 (IO_L10N_T1_13); also elsewhere on the board
DDR3_DQ45: U1.P23 (IO_L11P_T1_SRCC_13); also elsewhere on the board
DDR3_DQ46: U1.N23 (IO_L11N_T1_SRCC_13); also elsewhere on the board
DDR3_DQ47: U1.N21 (IO_L12P_T1_MRCC_13); also elsewhere on the board
DDR3_DQ48: U1.R21 (IO_L13P_T2_MRCC_13); also elsewhere on the board
DDR3_DQ49: U1.P21 (IO_L13N_T2_MRCC_13); also elsewhere on the board
DDR3_DQ50: U1.R22 (IO_L14P_T2_SRCC_13); also elsewhere on the board
DDR3_DQ51: U1.R23 (IO_L14N_T2_SRCC_13); also elsewhere on the board
DDR3_DQ52: U1.R20 (IO_L16N_T2_13); also elsewhere on the board
DDR3_DQ53: U1.T22 (IO_L17P_T2_13); also elsewhere on the board
DDR3_DQ54: U1.T23 (IO_L17N_T2_13); also elsewhere on the board
DDR3_DQ55: U1.U19 (IO_L18P_T2_13); also elsewhere on the board
DDR3_DQ56: U1.P16 (IO_L20P_T3_13); also elsewhere on the board
DDR3_DQ57: U1.N17 (IO_L20N_T3_13); also elsewhere on the board
DDR3_DQ58: U1.N18 (IO_L22P_T3_13); also elsewhere on the board
DDR3_DQ59: U1.M19 (IO_L22N_T3_13); also elsewhere on the board
DDR3_DQ60: U1.U17 (IO_L23P_T3_13); also elsewhere on the board
DDR3_DQ61: U1.T17 (IO_L23N_T3_13); also elsewhere on the board
DDR3_DQ62: U1.R18 (IO_L24P_T3_13); also elsewhere on the board
DDR3_DQ63: U1.P18 (IO_L24N_T3_13); also elsewhere on the board
DDR3_DQS0_N: U1.A17 (IO_L3N_T0_DQS_AD1N_15); also elsewhere on the board
DDR3_DQS0_P: U1.B17 (IO_L3P_T0_DQS_AD1P_15); also elsewhere on the board
DDR3_DQS1_N: U1.J16 (IO_L9N_T1_DQS_AD11N_15); also elsewhere on the board
DDR3_DQS1_P: U1.J15 (IO_L9P_T1_DQS_AD11P_15); also elsewhere on the board
DDR3_DQS2_N: U1.D20 (IO_L15N_T2_DQS_ADV_B_15); also elsewhere on the board
DDR3_DQS2_P: U1.D19 (IO_L15P_T2_DQS_15); also elsewhere on the board
DDR3_DQS3_N: U1.L20 (IO_L21N_T3_DQS_A18_15); also elsewhere on the board
DDR3_DQS3_P: U1.L19 (IO_L21P_T3_DQS_15); also elsewhere on the board
DDR3_DQS4_N: U1.L25 (IO_L3N_T0_DQS_13); also elsewhere on the board
DDR3_DQS4_P: U1.M25 (IO_L3P_T0_DQS_13); also elsewhere on the board
DDR3_DQS5_N: U1.P20 (IO_L9N_T1_DQS_13); also elsewhere on the board
DDR3_DQS5_P: U1.P19 (IO_L9P_T1_DQS_13); also elsewhere on the board
DDR3_DQS6_N: U1.T25 (IO_L15N_T2_DQS_13); also elsewhere on the board
DDR3_DQS6_P: U1.T24 (IO_L15P_T2_DQS_13); also elsewhere on the board
DDR3_DQS7_N: U1.R17 (IO_L21N_T3_DQS_13); also elsewhere on the board
DDR3_DQS7_P: U1.R16 (IO_L21P_T3_DQS_13); also elsewhere on the board
DDR3_ODT: U1.H21 (IO_L19P_T3_A10_D26_14); also elsewhere on the board
DDR3_RAS_N: U1.G26 (IO_L16N_T2_A15_D31_14); also elsewhere on the board
DDR3_RESET_N: U1.E17 (IO_L12N_T1_MRCC_AD5N_15); also elsewhere on the board
DDR3_WE_N: U1.E26 (IO_L17N_T2_A13_D29_14); also elsewhere on the board
GND: U1.A1 (GND), U1.A2 (GND), U1.A5 (GND), U1.A6 (GND), U1.A7 (GND), U1.A16 (GND), U1.A26 (GND), U1.AA6 (GND), U1.AA16 (GND), U1.AA26 (GND), U1.AB3 (GND), U1.AB13 (GND), U1.AB23 (GND), U1.AC10 (GND), U1.AC20 (GND), U1.AD7 (GND), U1.AD17 (GND), U1.AE4 (GND), U1.AE14 (GND), U1.AE24 (GND), U1.AF1 (GND), U1.AF11 (GND), U1.AF21 (GND), U1.B4 (GND), U1.B7 (GND), U1.B13 (GND), U1.B23 (GND), U1.C1 (GND), U1.C5 (GND), U1.C7 (GND), U1.C10 (GND), U1.C20 (GND), U1.D4 (GND), U1.D7 (GND), U1.D17 (GND), U1.E1 (GND), U1.E2 (GND), U1.E5 (GND), U1.E7 (GND), U1.E14 (GND), U1.E24 (GND), U1.F3 (GND), U1.F4 (GND), U1.F7 (GND), U1.F11 (GND), U1.F21 (GND), U1.G1 (GND), U1.G5 (GND), U1.G8 (GND), U1.G18 (GND), U1.H4 (GND), U1.H7 (GND), U1.H15 (GND), U1.H25 (GND), U1.J1 (GND), U1.J2 (GND), U1.J5 (GND), U1.J12 (GND), U1.J22 (GND), U1.K3 (GND), U1.K4 (GND), U1.K7 (GND), U1.K9 (GND), U1.K11 (GND), U1.K13 (GND), U1.K19 (GND), U1.L1 (GND), U1.L5 (GND), U1.L10 (GND), U1.L12 (GND), U1.L14 (GND), U1.L16 (GND), U1.L26 (GND), U1.M4 (GND), U1.M7 (GND), U1.M9 (GND), U1.M11 (GNDADC_0), U1.M13 (GND), U1.M15 (GND), U1.M23 (GND), U1.N1 (GND), U1.N2 (GND), U1.N5 (GND), U1.N7 (GND), U1.N10 (GND), U1.N14 (GND), U1.N20 (GND), U1.P3 (GND), U1.P4 (GND), U1.P9 (GND), U1.P13 (GND), U1.P15 (GND), U1.P17 (GND), U1.R1 (GND), U1.R2 (GND), U1.R5 (GND), U1.R8 (GND), U1.R10 (GND), U1.R14 (GND), U1.R24 (GND), U1.T1 (GND), U1.T3 (GND), U1.T4 (GND), U1.T9 (GND), U1.T11 (GND), U1.T13 (GND), U1.T15 (GND), U1.T21 (GND), U1.U8 (GND), U1.U10 (GND), U1.U12 (GND), U1.U14 (GND), U1.U18 (GND), U1.V5 (GND), U1.V15 (GND), U1.V25 (GND), U1.W2 (GND), U1.W12 (GND), U1.W22 (GND), U1.Y9 (GND), U1.Y19 (GND); also elsewhere on the board
VCC1.0: U1.J9 (VCCINT), U1.K8 (VCCINT), U1.K10 (VCCINT), U1.K12 (VCCINT), U1.K14 (VCCINT), U1.L9 (VCCINT), U1.L13 (VCCINT), U1.L15 (VCCINT), U1.M8 (VCCINT), U1.M14 (VCCINT), U1.N9 (VCCINT), U1.N13 (VCCBRAM), U1.N15 (VCCINT), U1.P14 (VCCINT), U1.R13 (VCCBRAM), U1.R15 (VCCINT), U1.T12 (VCCBRAM), U1.T14 (VCCINT), U1.U13 (VCCBRAM), U1.U15 (VCCINT)
VCC1.8: U1.E8 (VCCBATT_0), U1.L11 (VCCAUX), U1.M10 (VCCAUX), U1.M12 (VCCADC_0), U1.P8 (VCCAUX_IO_G0), U1.P10 (VCCAUX), U1.R9 (VCCAUX_IO_G0), U1.T8 (VCCAUX_IO_G0), U1.T10 (VCCAUX), U1.U11 (VCCAUX)
