kostareg/zenith/zenith-pcba/zenith-pcba.kicad_pcb

## KiCad design zenith-pcba/zenith-pcba.kicad_pcb (continued)

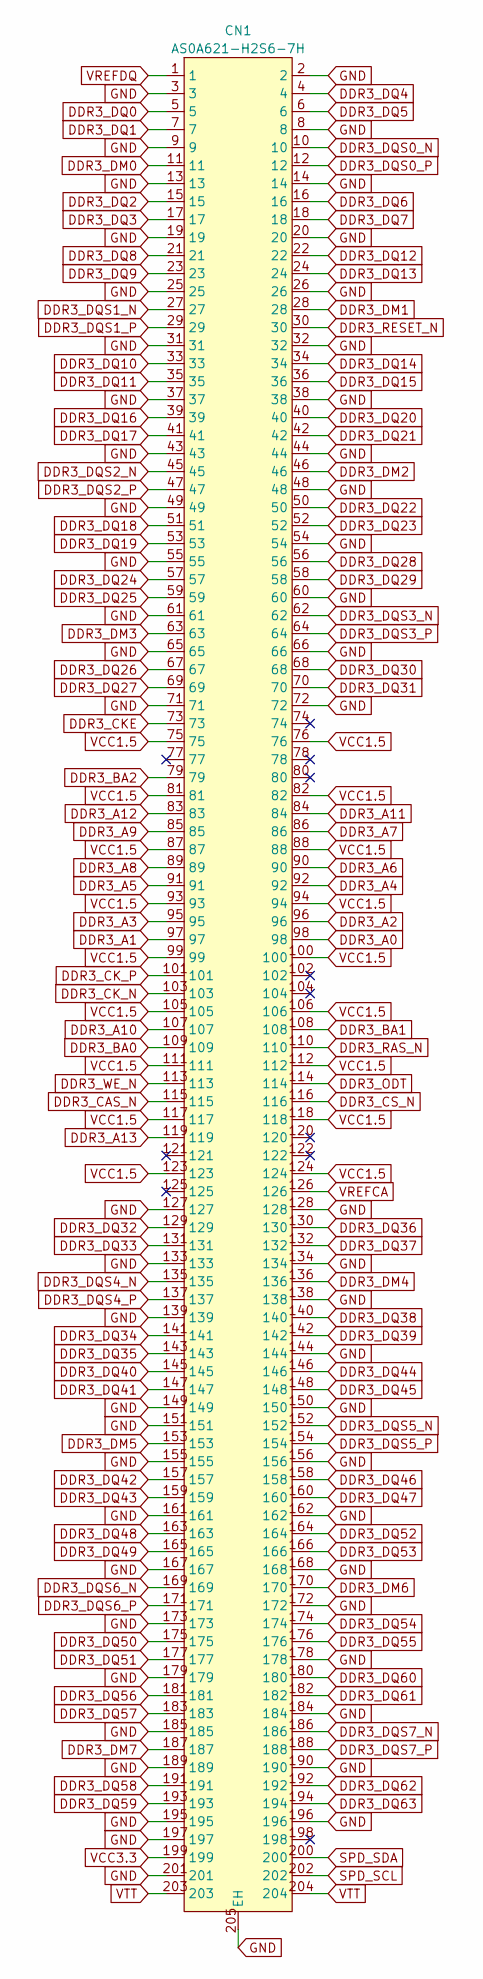
[picture p7: schematic todo.kicad_sch]

Parts:
CN1: AS0A621-H2S6-7H; CONN-SMD_204P-P0.60_AS0A621-H2S6-7H; MPN AS0A621-H2S6-7H; LCSC Part C225721

Connections:
DDR3_A0: CN1.98; also elsewhere on the board
DDR3_A1: CN1.97; also elsewhere on the board
DDR3_A2: CN1.96; also elsewhere on the board
DDR3_A3: CN1.95; also elsewhere on the board
DDR3_A4: CN1.92; also elsewhere on the board
DDR3_A5: CN1.91; also elsewhere on the board
DDR3_A6: CN1.90; also elsewhere on the board
DDR3_A7: CN1.86; also elsewhere on the board
DDR3_A8: CN1.89; also elsewhere on the board
DDR3_A9: CN1.85; also elsewhere on the board
DDR3_A10: CN1.107; also elsewhere on the board
DDR3_A11: CN1.84; also elsewhere on the board
DDR3_A12: CN1.83; also elsewhere on the board
DDR3_A13: CN1.119; also elsewhere on the board
DDR3_BA0: CN1.109; also elsewhere on the board
DDR3_BA1: CN1.108; also elsewhere on the board
DDR3_BA2: CN1.79; also elsewhere on the board
DDR3_CAS_N: CN1.115; also elsewhere on the board
DDR3_CKE: CN1.73; also elsewhere on the board
DDR3_CK_N: CN1.103; also elsewhere on the board
DDR3_CK_P: CN1.101; also elsewhere on the board
DDR3_CS_N: CN1.116; also elsewhere on the board
DDR3_DM0: CN1.11; also elsewhere on the board
DDR3_DM1: CN1.28; also elsewhere on the board
DDR3_DM2: CN1.46; also elsewhere on the board
DDR3_DM3: CN1.63; also elsewhere on the board
DDR3_DM4: CN1.136; also elsewhere on the board
DDR3_DM5: CN1.153; also elsewhere on the board
DDR3_DM6: CN1.170; also elsewhere on the board
DDR3_DM7: CN1.187; also elsewhere on the board
DDR3_DQ0: CN1.5; also elsewhere on the board
DDR3_DQ1: CN1.7; also elsewhere on the board
DDR3_DQ2: CN1.15; also elsewhere on the board
DDR3_DQ3: CN1.17; also elsewhere on the board
DDR3_DQ4: CN1.4; also elsewhere on the board
DDR3_DQ5: CN1.6; also elsewhere on the board
DDR3_DQ6: CN1.16; also elsewhere on the board
DDR3_DQ7: CN1.18; also elsewhere on the board
DDR3_DQ8: CN1.21; also elsewhere on the board
DDR3_DQ9: CN1.23; also elsewhere on the board
DDR3_DQ10: CN1.33; also elsewhere on the board
DDR3_DQ11: CN1.35; also elsewhere on the board
DDR3_DQ12: CN1.22; also elsewhere on the board
DDR3_DQ13: CN1.24; also elsewhere on the board
DDR3_DQ14: CN1.34; also elsewhere on the board
DDR3_DQ15: CN1.36; also elsewhere on the board
DDR3_DQ16: CN1.39; also elsewhere on the board
DDR3_DQ17: CN1.41; also elsewhere on the board
DDR3_DQ18: CN1.51; also elsewhere on the board
DDR3_DQ19: CN1.53; also elsewhere on the board
DDR3_DQ20: CN1.40; also elsewhere on the board
DDR3_DQ21: CN1.42; also elsewhere on the board
DDR3_DQ22: CN1.50; also elsewhere on the board
DDR3_DQ23: CN1.52; also elsewhere on the board
DDR3_DQ24: CN1.57; also elsewhere on the board
DDR3_DQ25: CN1.59; also elsewhere on the board
DDR3_DQ26: CN1.67; also elsewhere on the board
DDR3_DQ27: CN1.69; also elsewhere on the board
DDR3_DQ28: CN1.56; also elsewhere on the board
DDR3_DQ29: CN1.58; also elsewhere on the board
DDR3_DQ30: CN1.68; also elsewhere on the board
DDR3_DQ31: CN1.70; also elsewhere on the board
DDR3_DQ32: CN1.129; also elsewhere on the board
DDR3_DQ33: CN1.131; also elsewhere on the board
DDR3_DQ34: CN1.141; also elsewhere on the board
DDR3_DQ35: CN1.143; also elsewhere on the board
DDR3_DQ36: CN1.130; also elsewhere on the board
DDR3_DQ37: CN1.132; also elsewhere on the board
DDR3_DQ38: CN1.140; also elsewhere on the board
DDR3_DQ39: CN1.142; also elsewhere on the board
DDR3_DQ40: CN1.145; also elsewhere on the board
DDR3_DQ41: CN1.147; also elsewhere on the board
DDR3_DQ42: CN1.157; also elsewhere on the board
DDR3_DQ43: CN1.159; also elsewhere on the board
DDR3_DQ44: CN1.146; also elsewhere on the board
DDR3_DQ45: CN1.148; also elsewhere on the board
DDR3_DQ46: CN1.158; also elsewhere on the board
DDR3_DQ47: CN1.160; also elsewhere on the board
DDR3_DQ48: CN1.163; also elsewhere on the board
DDR3_DQ49: CN1.165; also elsewhere on the board
DDR3_DQ50: CN1.175; also elsewhere on the board
DDR3_DQ51: CN1.177; also elsewhere on the board
DDR3_DQ52: CN1.164; also elsewhere on the board
DDR3_DQ53: CN1.166; also elsewhere on the board
DDR3_DQ54: CN1.174; also elsewhere on the board
DDR3_DQ55: CN1.176; also elsewhere on the board
DDR3_DQ56: CN1.181; also elsewhere on the board
DDR3_DQ57: CN1.183; also elsewhere on the board
DDR3_DQ58: CN1.191; also elsewhere on the board
DDR3_DQ59: CN1.193; also elsewhere on the board
DDR3_DQ60: CN1.180; also elsewhere on the board
DDR3_DQ61: CN1.182; also elsewhere on the board
DDR3_DQ62: CN1.192; also elsewhere on the board
DDR3_DQ63: CN1.194; also elsewhere on the board
DDR3_DQS0_N: CN1.10; also elsewhere on the board
DDR3_DQS0_P: CN1.12; also elsewhere on the board
DDR3_DQS1_N: CN1.27; also elsewhere on the board
DDR3_DQS1_P: CN1.29; also elsewhere on the board
DDR3_DQS2_N: CN1.45; also elsewhere on the board
DDR3_DQS2_P: CN1.47; also elsewhere on the board
DDR3_DQS3_N: CN1.62; also elsewhere on the board
DDR3_DQS3_P: CN1.64; also elsewhere on the board
DDR3_DQS4_N: CN1.135; also elsewhere on the board
DDR3_DQS4_P: CN1.137; also elsewhere on the board
DDR3_DQS5_N: CN1.152; also elsewhere on the board
DDR3_DQS5_P: CN1.154; also elsewhere on the board
DDR3_DQS6_N: CN1.169; also elsewhere on the board
DDR3_DQS6_P: CN1.171; also elsewhere on the board
DDR3_DQS7_N: CN1.186; also elsewhere on the board
DDR3_DQS7_P: CN1.188; also elsewhere on the board
DDR3_ODT: CN1.114; also elsewhere on the board
DDR3_RAS_N: CN1.110; also elsewhere on the board
DDR3_RESET_N: CN1.30; also elsewhere on the board
DDR3_WE_N: CN1.113; also elsewhere on the board
GND: CN1.2, CN1.3, CN1.8, CN1.9, CN1.13, CN1.14, CN1.19, CN1.20, CN1.25, CN1.26, CN1.31, CN1.32, CN1.37, CN1.38, CN1.43, CN1.44, CN1.48, CN1.49, CN1.54, CN1.55, CN1.60, CN1.61, CN1.65, CN1.66, CN1.71, CN1.72, CN1.127, CN1.128, CN1.133, CN1.134, CN1.138, CN1.139, CN1.144, CN1.149, CN1.150, CN1.151, CN1.155, CN1.156, CN1.161, CN1.162, CN1.167, CN1.168, CN1.172, CN1.173, CN1.178, CN1.179, CN1.184, CN1.185, CN1.189, CN1.190, CN1.195, CN1.196, CN1.197, CN1.201, CN1.205 (EH); also elsewhere on the board
SPD_SCL: CN1.202
SPD_SDA: CN1.200
VCC1.5: CN1.75, CN1.76, CN1.81, CN1.82, CN1.87, CN1.88, CN1.93, CN1.94, CN1.99, CN1.100, CN1.105, CN1.106, CN1.111, CN1.112, CN1.117, CN1.118, CN1.123, CN1.124
VCC3.3: CN1.199; also elsewhere on the board
VREFCA: CN1.126
VREFDQ: CN1.1
VTT: CN1.203, CN1.204

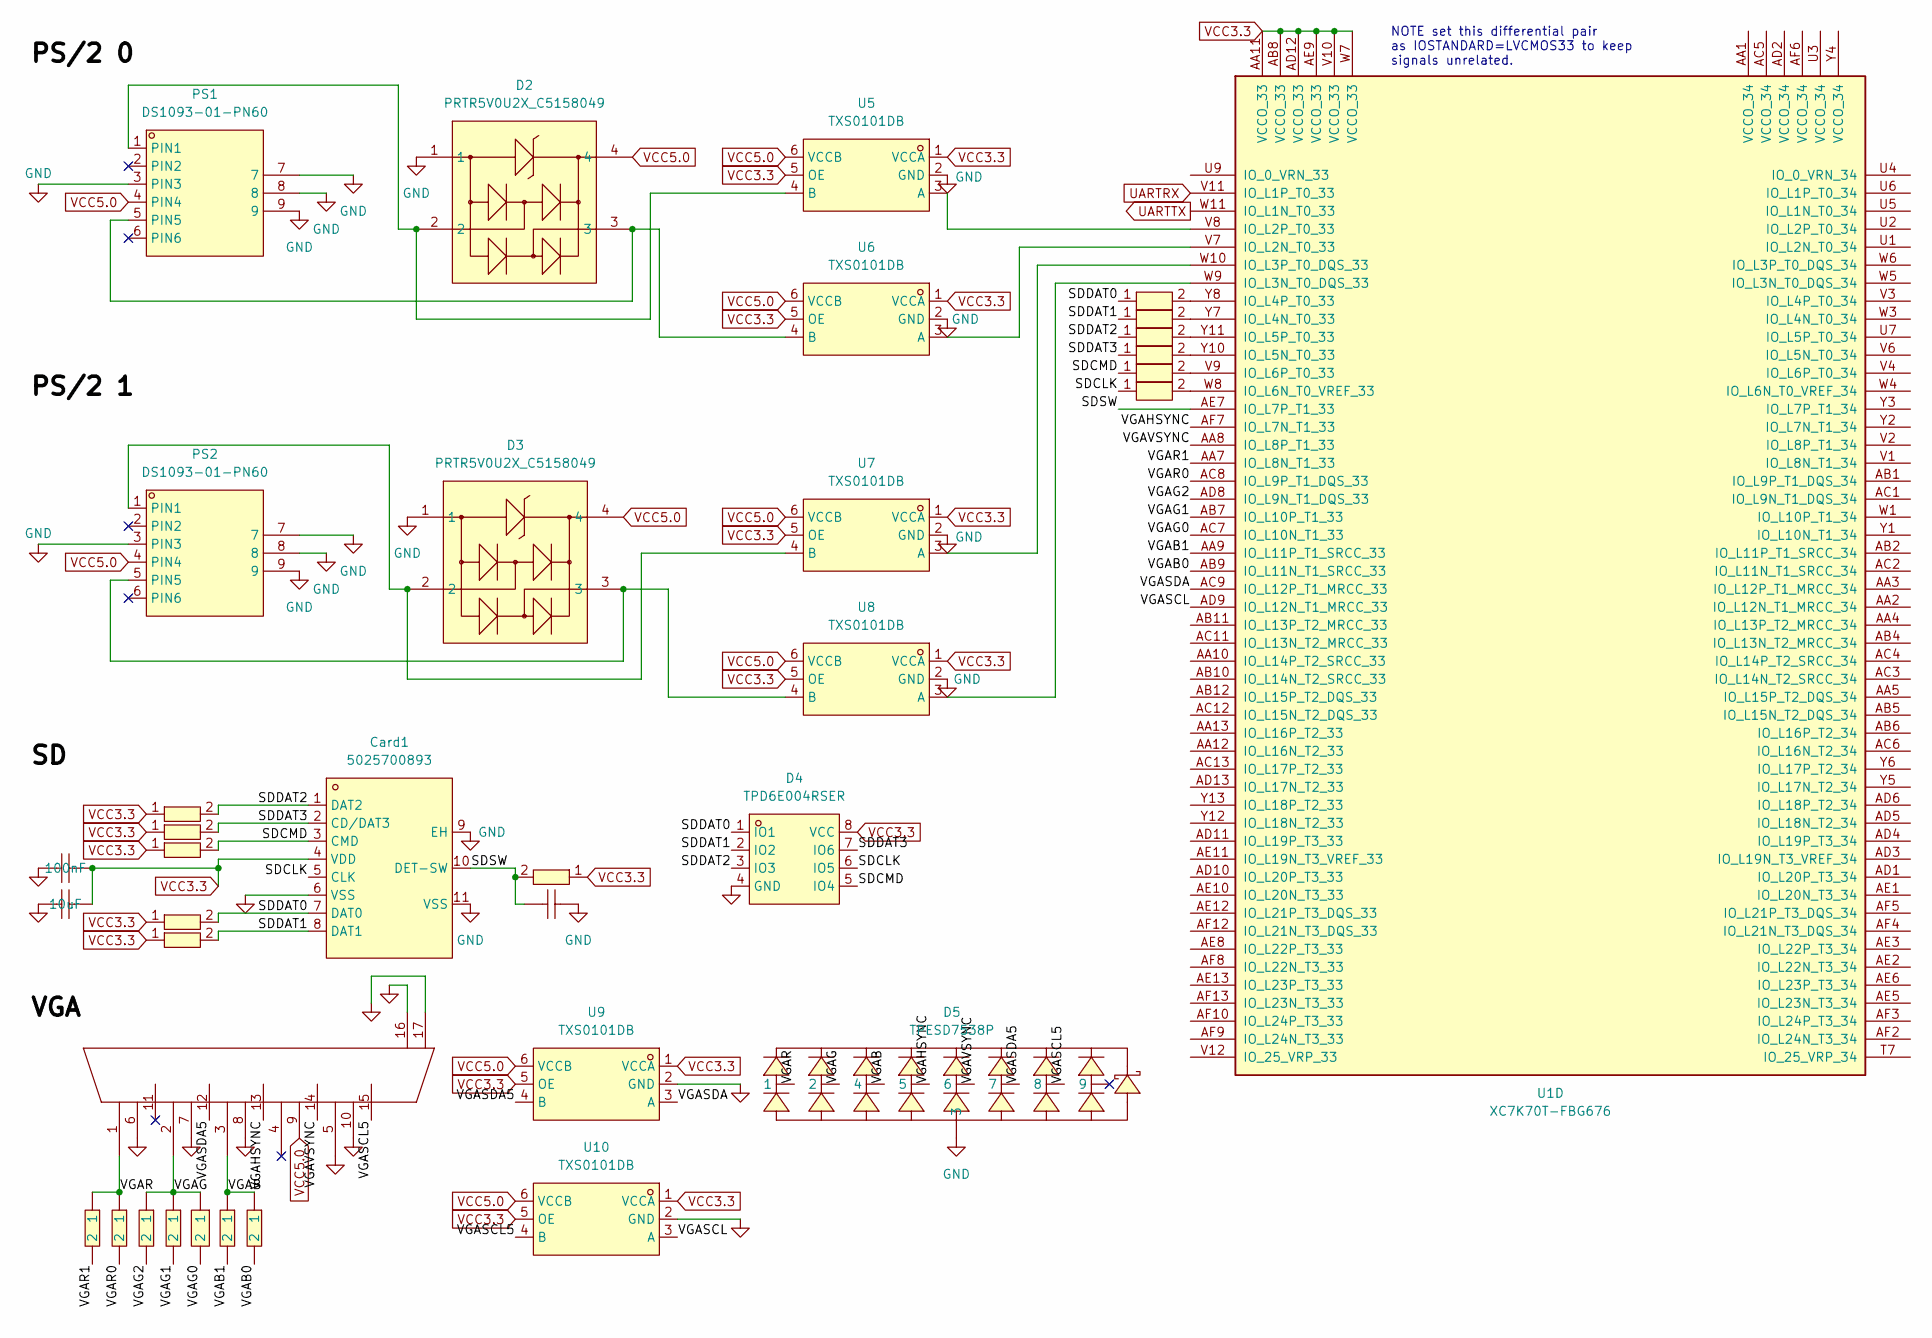
[picture p8: schematic todop.kicad_sch]

Parts:
C8, C9: CL10B104KA8NNNC; C0603; MPN CL10B104KA8NNNC; LCSC Part C1590
C10: CC0603MRX5R7BB106; C0603; MPN CC0603MRX5R7BB106; LCSC Part C109457
Card1: 5025700893; TF-SMD_5025700893; MPN 5025700893; LCSC Part C429846
D2, D3: PRTR5V0U2X_C5158049; SOT-143_L2.9-W1.3-P1.92-LS2.3-BL; MPN PRTR5V0U2X; LCSC Part C5158049
D4: TPD6E004RSER; UQFN-8_L1.5-W1.5-P0.50-TL; MPN TPD6E004RSER; LCSC Part C1973052
D5: TPESD7538P; DFN3810-9_L3.8-W1.0-P0.9; MPN TPESD7538P; LCSC Part C970014
DSub1: DS1038-15FBNSIA74-0CC; DSUB-TH_DS1038-15FBNSIA74-0CC; MPN DS1038-15FBNSiA74-0CC; LCSC Part C75754
PS1, PS2: DS1093-01-PN60; CONN-TH_DS1093-01-PN60; MPN DS1093-01-PN60; LCSC Part C77848
R5, R6, R7, R8, R9, R16: RC0402FR-0710KL; R0402; MPN RC0402FR-0710KL; LCSC Part C60490
R10, R11, R12, R13, R14, R15: RC0402FR-0722R1L; R0402; MPN RC0402FR-0722R1L; LCSC Part C327363
R17, R19, R21: RC0402JR-07510RL; R0402; MPN RC0402JR-07510RL; LCSC Part C137860
R18, R20, R22: RC0402FR-071K02L; R0402; MPN RC0402FR-071K02L; LCSC Part C163485
R23: RC0402DR-072K05L; R0402; MPN RC0402DR-072K05L; LCSC Part C471776
U1: XC7K70T-FBG676; FBGA-676_L27.0-W27.0-R26-C26-P1.00-BL
U5, U6, U7, U8, U9, U10: TXS0101DB; SOT-23-6_L2.9-W1.6-P0.95-LS2.9-BL; MPN TXS0101DB(LX); LCSC Part C22469953

Connections:
/IO/SDCLK: Card1.5 (CLK), D4.6 (IO5), R15.1
/IO/SDCMD: Card1.3 (CMD), D4.5 (IO4), R7.2, R14.1
/IO/SDDAT0: Card1.7 (DAT0), D4.1 (IO1), R8.2, R10.1
/IO/SDDAT1: Card1.8 (DAT1), D4.2 (IO2), R9.2, R11.1
/IO/SDDAT2: Card1.1 (DAT2), D4.3 (IO3), R5.2, R12.1
/IO/SDDAT3: Card1.2 (CD/DAT3), D4.7 (IO6), R6.2, R13.1
/IO/SDSW: C8.1, Card1.10 (DET-SW), R16.2, U1.AE7 (IO_L7P_T1_33)
/IO/VGAB: D5.4, DSub1.3, R21.1, R22.1
/IO/VGAB0: R22.2, U1.AB9 (IO_L11N_T1_SRCC_33)
/IO/VGAB1: R21.2, U1.AA9 (IO_L11P_T1_SRCC_33)
/IO/VGAG: D5.2, DSub1.2, R19.1, R20.1, R23.1
/IO/VGAG0: R23.2, U1.AC7 (IO_L10N_T1_33)
/IO/VGAG1: R20.2, U1.AB7 (IO_L10P_T1_33)
/IO/VGAG2: R19.2, U1.AD8 (IO_L9N_T1_DQS_33)
/IO/VGAHSYNC: D5.5, DSub1.13, U1.AF7 (IO_L7N_T1_33)
/IO/VGAR: D5.1, DSub1.1, R17.1, R18.1
/IO/VGAR0: R18.2, U1.AC8 (IO_L9P_T1_DQS_33)
/IO/VGAR1: R17.2, U1.AA7 (IO_L8N_T1_33)
/IO/VGASCL: U1.AD9 (IO_L12N_T1_MRCC_33), U10.3 (A)
/IO/VGASCL5: D5.8, DSub1.15, U10.4 (B)
/IO/VGASDA: U1.AC9 (IO_L12P_T1_MRCC_33), U9.3 (A)
/IO/VGASDA5: D5.7, DSub1.12, U9.4 (B)
/IO/VGAVSYNC: D5.6, DSub1.14, U1.AA8 (IO_L8P_T1_33)
GND: C8.2, C9.1, C10.1, Card1.6 (VSS), Card1.9 (EH), Card1.11 (VSS), D2.1, D3.1, D4.4 (GND), D5.3, DSub1.5, DSub1.6, DSub1.7, DSub1.8, DSub1.10, DSub1.16, DSub1.17, PS1.3 (PIN3), PS1.7, PS1.8, PS1.9, PS2.3 (PIN3), PS2.7, PS2.8, PS2.9, U5.2 (GND), U6.2 (GND), U7.2 (GND), U8.2 (GND), U9.2 (GND), U10.2 (GND); also elsewhere on the board
unnamed: D2.2, PS1.1 (PIN1), U5.4 (B)
unnamed: D2.3, PS1.5 (PIN5), U6.4 (B)
unnamed: D3.2, PS2.1 (PIN1), U7.4 (B)
unnamed: D3.3, PS2.5 (PIN5), U8.4 (B)
unnamed: U1.V7 (IO_L2N_T0_33), U6.3 (A)
unnamed: U1.V8 (IO_L2P_T0_33), U5.3 (A)
unnamed: U1.W9 (IO_L3N_T0_DQS_33), U8.3 (A)
unnamed: U1.W10 (IO_L3P_T0_DQS_33), U7.3 (A)
unnamed: R11.2, U1.Y7 (IO_L4N_T0_33)
unnamed: R10.2, U1.Y8 (IO_L4P_T0_33)
unnamed: R13.2, U1.Y10 (IO_L5N_T0_33)
unnamed: R12.2, U1.Y11 (IO_L5P_T0_33)
unnamed: R15.2, U1.W8 (IO_L6N_T0_VREF_33)
unnamed: R14.2, U1.V9 (IO_L6P_T0_33)
UARTRX: U1.V11 (IO_L1P_T0_33); also elsewhere on the board
UARTTX: U1.W11 (IO_L1N_T0_33); also elsewhere on the board
VCC3.3: C9.2, C10.2, Card1.4 (VDD), D4.8 (VCC), R5.1, R6.1, R7.1, R8.1, R9.1, R16.1, U1.AA11 (VCCO_33), U1.AB8 (VCCO_33), U1.AD12 (VCCO_33), U1.AE9 (VCCO_33), U1.V10 (VCCO_33), U1.W7 (VCCO_33), U5.1 (VCCA), U5.5 (OE), U6.1 (VCCA), U6.5 (OE), U7.1 (VCCA), U7.5 (OE), U8.1 (VCCA), U8.5 (OE), U9.1 (VCCA), U9.5 (OE), U10.1 (VCCA), U10.5 (OE); also elsewhere on the board
VCC5.0: D2.4, D3.4, DSub1.9, PS1.4 (PIN4), PS2.4 (PIN4), U5.6 (VCCB), U6.6 (VCCB), U7.6 (VCCB), U8.6 (VCCB), U9.6 (VCCB), U10.6 (VCCB); also elsewhere on the board

Notes on the sheet:
NOTE set this differential pair as IOSTANDARD=LVCMOS33 to keep signals unrelated.

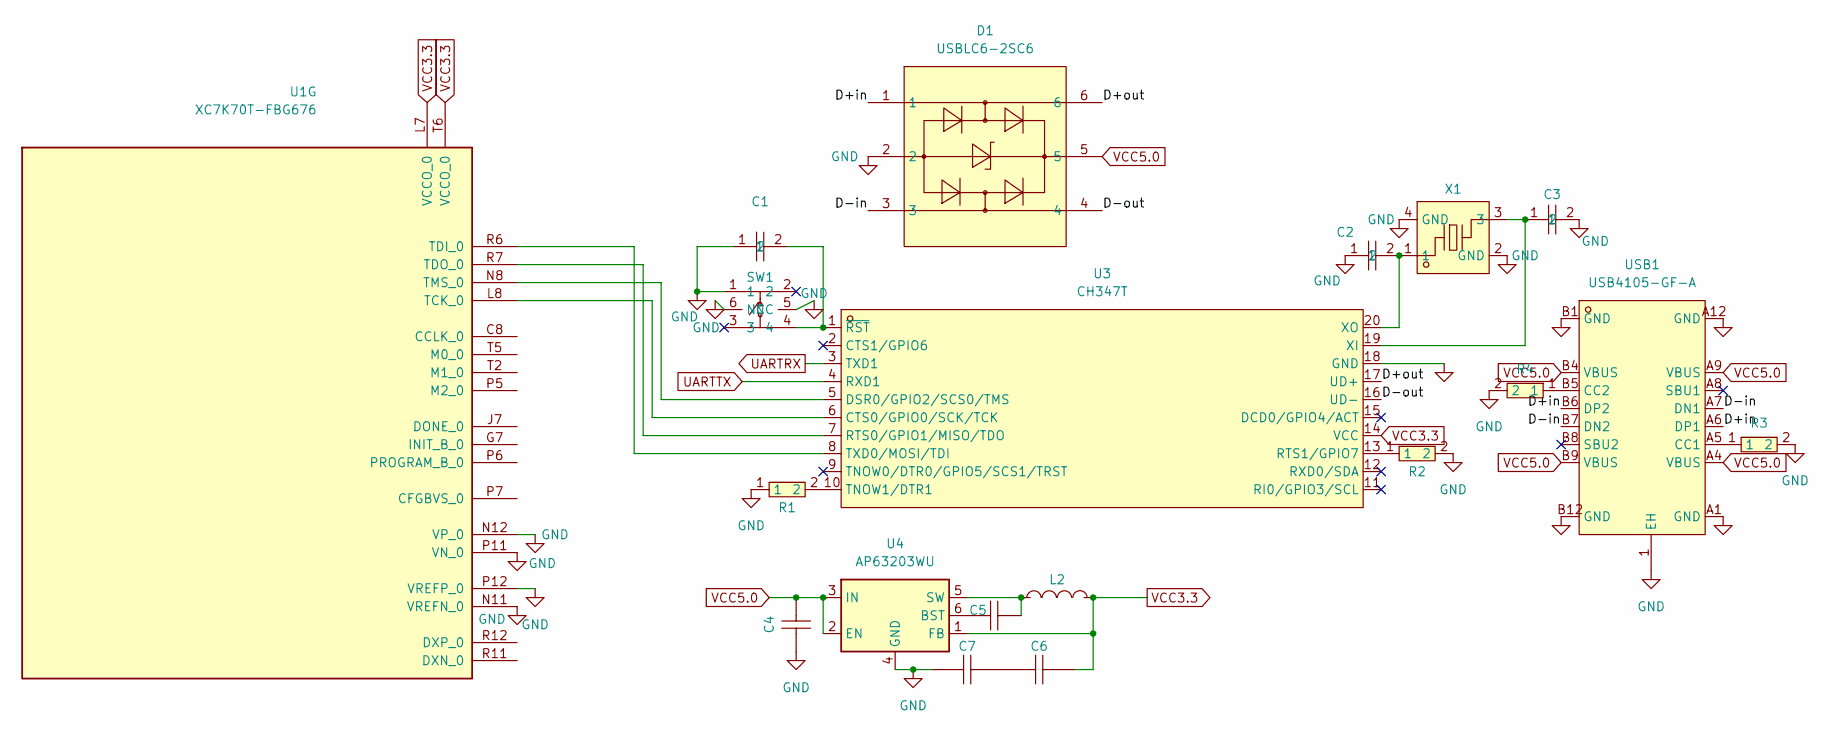
[picture p9: schematic programmerrealkicad_sch.kicad_sch]

Parts:
C1, C5: CL10B104KA8NNNC; C0603; MPN CL10B104KA8NNNC; LCSC Part C1590
C2, C3: 0402CG220J500NT; C0402; MPN 0402CG220J500NT; LCSC Part C1555
C4: CC0603MRX5R7BB106; C0603; MPN CC0603MRX5R7BB106; LCSC Part C109457
C6, C7: CC1206KKX7R6BB226; C1206; MPN CC1206KKX7R6BB226; LCSC Part C110045
D1: USBLC6-2SC6; SOT-23-6_L2.9-W1.6-P0.95-LS2.8-BL; MPN USBLC6-2SC6; LCSC Part C7519
L2: SWPA4030S3R3MT; IND-SMD_L4.0-W4.0_SMNR4012; MPN SWPA4030S3R3MT; LCSC Part C15269
R1, R2: RC0603FR-074K7L; R0603; MPN RC0603FR-074K7L; LCSC Part C99782
R3, R4: RC0603JR-075K1L; R0603; MPN RC0603JR-075K1L; LCSC Part C14677
SW1: G4R152312; SW-SMD_4P-L5.2-W5.2-P3.70-LS6.4_UK-B0233XX; MPN G4R152312; LCSC Part C49393646
U1: XC7K70T-FBG676; FBGA-676_L27.0-W27.0-R26-C26-P1.00-BL
U3: CH347T; TSSOP-20_L6.5-W4.4-P0.65-LS6.4-BL; MPN CH347T; LCSC Part C5122332
U4: AP63203WU; TSOT-23-6
USB1: USB4105-GF-A; TYPE-C-SMD_SBC-160S1A-20-S412; MPN USB4105-GF-A; LCSC Part C3020560
X1: SX5B8.000F1520F30; CYSTAL-SMD_4P-L5.0-W3.2-BL; MPN SX5B8.000F1520F30; LCSC Part C2901621

Connections:
/Programmer/D+in: D1.1, USB1.A6 (DP1), USB1.B6 (DP2)
/Programmer/D+out: D1.6, U3.17 (UD+)
/Programmer/D-in: D1.3, USB1.A7 (DN1), USB1.B7 (DN2)
/Programmer/D-out: D1.4, U3.16 (UD-)
GND: C1.1, C2.1, C3.2, C4.2, C7.1, D1.2, R1.1, R2.2, R3.2, R4.2, SW1.1, SW1.5 (NC), SW1.6 (NC), U1.N11 (VREFN_0), U1.N12 (VP_0), U1.P11 (VN_0), U1.P12 (VREFP_0), U3.18 (GND), U4.4 (GND), USB1.1 (EH), USB1.A1 (GND), USB1.A12 (GND), USB1.B1 (GND), USB1.B12 (GND), X1.2 (GND), X1.4 (GND); also elsewhere on the board
unnamed: C6.1, C7.2
unnamed: U1.L8 (TCK_0), U3.6 (CTS0/GPIO0/SCK/TCK)
unnamed: U1.R6 (TDI_0), U3.8 (TXD0/MOSI/TDI)
unnamed: U1.R7 (TDO_0), U3.7 (RTS0/GPIO1/MISO/TDO)
unnamed: U1.N8 (TMS_0), U3.5 (DSR0/GPIO2/SCS0/TMS)
unnamed: R2.1, U3.13 (RTS1/GPIO7)
unnamed: R1.2, U3.10 (TNOW1/DTR1)
unnamed: C3.1, U3.19 (XI), X1.3
unnamed: C2.2, U3.20 (XO), X1.1
unnamed: C1.2, SW1.4, U3.1 (~RST)
unnamed: C5.1, U4.6 (BST)
unnamed: C5.2, L2.1, U4.5 (SW)
unnamed: R3.1, USB1.A5 (CC1)
unnamed: R4.1, USB1.B5 (CC2)
UARTRX: U3.3 (TXD1); also elsewhere on the board
UARTTX: U3.4 (RXD1); also elsewhere on the board
VCC3.3: C6.2, L2.2, U1.L7 (VCCO_0), U1.T6 (VCCO_0), U3.14 (VCC), U4.1 (FB); also elsewhere on the board
VCC5.0: C4.1, D1.5, U4.2 (EN), U4.3 (IN), USB1.A4 (VBUS), USB1.A9 (VBUS), USB1.B4 (VBUS), USB1.B9 (VBUS); also elsewhere on the board

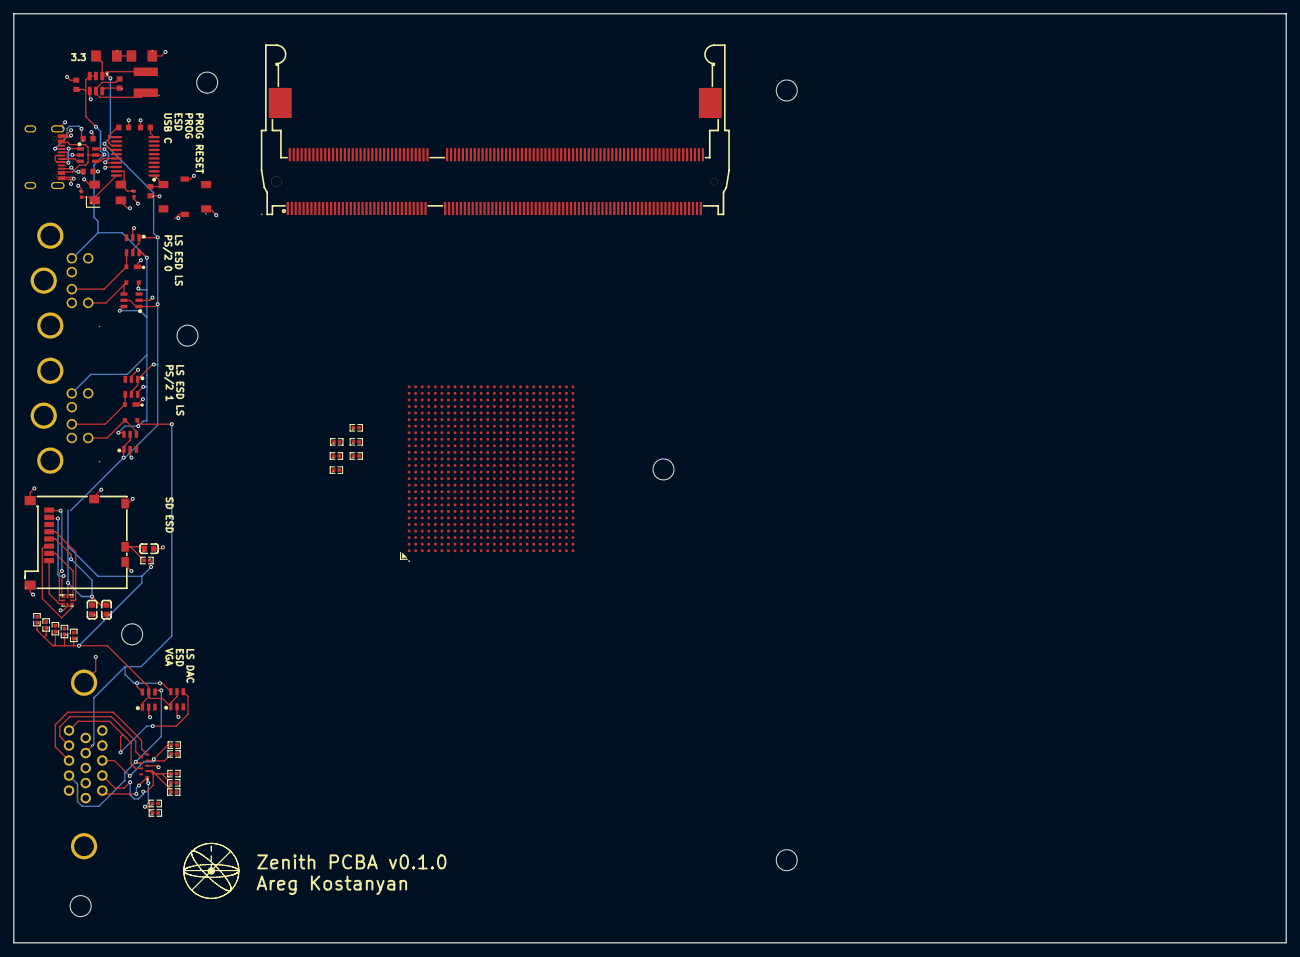
[picture p10: board zenith-pcba.kicad_pcb from above]

Board: 2 copper layers, 194.1 x 141.7 mm, 56 parts (0 on the bottom side), 178 nets.
