kostareg/zenith/zenith-libc/stdio.h

#define __ZENITH_LIBC_ASCII_FONT_WIDTH 8
#define __ZENITH_LIBC_ASCII_FONT_HEIGHT 16
#define __ZENITH_LIBC_ASCII_FONT_FIRST 0
#define __ZENITH_LIBC_ASCII_FONT_COUNT 128

#define __ZENITH_LIBC_FONT_SCALE 2

#define __ZENITH_LIBC_CELL_WIDTH (__ZENITH_LIBC_ASCII_FONT_WIDTH * __ZENITH_LIBC_FONT_SCALE)
#define __ZENITH_LIBC_CELL_HEIGHT (__ZENITH_LIBC_ASCII_FONT_HEIGHT * __ZENITH_LIBC_FONT_SCALE)

#define __ZENITH_LIBC_LINE_HEIGHT (__ZENITH_LIBC_CELL_HEIGHT + (3 * __ZENITH_LIBC_FONT_SCALE))

uint8_t __ZENITH_LIBC_ASCII_BITMAP[__ZENITH_LIBC_ASCII_FONT_COUNT * __ZENITH_LIBC_ASCII_FONT_HEIGHT] = {
    /* 0x00 NUL */
    0x00, 0x00, 0x00, 0x00, 0x00, 0x00, 0x00, 0x00, 0x00, 0x00, 0x00, 0x00, 0x00, 0x00, 0x00, 0x00,
    /* 0x01 SOH */
    0x00, 0x00, 0x00, 0x00, 0x00, 0x00, 0x00, 0x00, 0x00, 0x00, 0x00, 0x00, 0x00, 0x00, 0x00, 0x00,
    /* 0x02 STX */
    0x00, 0x00, 0x00, 0x00, 0x00, 0x00, 0x00, 0x00, 0x00, 0x00, 0x00, 0x00, 0x00, 0x00, 0x00, 0x00,
    /* 0x03 ETX */
    0x00, 0x00, 0x00, 0x00, 0x00, 0x00, 0x00, 0x00, 0x00, 0x00, 0x00, 0x00, 0x00, 0x00, 0x00, 0x00,
    /* 0x04 EOT */
    0x00, 0x00, 0x00, 0x00, 0x00, 0x00, 0x00, 0x00, 0x00, 0x00, 0x00, 0x00, 0x00, 0x00, 0x00, 0x00,
    /* 0x05 ENQ */
    0x00, 0x00, 0x00, 0x00, 0x00, 0x00, 0x00, 0x00, 0x00, 0x00, 0x00, 0x00, 0x00, 0x00, 0x00, 0x00,
    /* 0x06 ACK */
    0x00, 0x00, 0x00, 0x00, 0x00, 0x00, 0x00, 0x00, 0x00, 0x00, 0x00, 0x00, 0x00, 0x00, 0x00, 0x00,
    /* 0x07 BEL */
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
    /* 0x2B   + */
    0x00, 0x00, 0x00, 0x00, 0x00, 0x18, 0x18, 0x18, 0xFE, 0x18, 0x18, 0x18, 0x00, 0x00, 0x00, 0x00,
    /* 0x2C   , */
    0x00, 0x00, 0x00, 0x00, 0x00, 0x00, 0x00, 0x00, 0x00, 0x00, 0x00, 0x18, 0x18, 0x10, 0x10, 0x00,
    /* 0x2D   - */
    0x00, 0x00, 0x00, 0x00, 0x00, 0x00, 0x00, 0x00, 0x00, 0x3C, 0x00, 0x00, 0x00, 0x00, 0x00, 0x00,
    /* 0x2E   . */
    0x00, 0x00, 0x00, 0x00, 0x00, 0x00, 0x00, 0x00, 0x00, 0x00, 0x00, 0x18, 0x18, 0x00, 0x00, 0x00,
    /* 0x2F   / */
    0x00, 0x00, 0x00, 0x00, 0x06, 0x04, 0x0C, 0x08, 0x18, 0x10, 0x10, 0x30, 0x20, 0x60, 0x40, 0x00,
    /* 0x30   0 */
    0x00, 0x00, 0x00, 0x00, 0x3C, 0x66, 0x66, 0x46, 0x5A, 0x46, 0x66, 0x66, 0x3C, 0x00, 0x00, 0x00,
    /* 0x31   1 */
    0x00, 0x00, 0x00, 0x00, 0x78, 0x08, 0x08, 0x08, 0x08, 0x08, 0x08, 0x08, 0x3E, 0x00, 0x00, 0x00,
    /* 0x32   2 */
    0x00, 0x00, 0x00, 0x00, 0x3C, 0x46, 0x06, 0x06, 0x0C, 0x18, 0x30, 0x60, 0x7E, 0x00, 0x00, 0x00,
    /* 0x33   3 */
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
    /* 0x7F DEL */
    0x00, 0x00, 0x00, 0x00, 0x00, 0x00, 0x00, 0x00, 0x00, 0x00, 0x00, 0x00, 0x00, 0x00, 0x00, 0x00,
};

#define __ZENITH_LIBC_FB_WIDTH 1920
#define __ZENITH_LIBC_FB_HEIGHT 1080
#define __ZENITH_LIBC_FB_PIXEL_BASE 0xffffffffffa11400ULL
#define __ZENITH_LIBC_FB_CONTROL_BASE 0xffffffffffa01400ULL

void enable_framebuffer() {
    long *control = __ZENITH_LIBC_FB_CONTROL_BASE;
    *control = 2L << 32;
}

void __zenith_libc_put_white_pixel(int x, int y) {
    if (x < 0) return;
    if ((x - __ZENITH_LIBC_FB_WIDTH) >= 0) return;
    if (y < 0) return;
    if ((y - __ZENITH_LIBC_FB_HEIGHT) >= 0) return;

    long pixel_offset = ((y * __ZENITH_LIBC_FB_WIDTH) + x) * 3;

    unsigned char *pixel = __ZENITH_LIBC_FB_PIXEL_BASE + pixel_offset;
    pixel[0] = 255;
    pixel[1] = 255;
    pixel[2] = 255;
}

int __zenith_libc_ascii_font_pixel(unsigned char c, int x, int y) {
    unsigned char row;

    if (c >= __ZENITH_LIBC_ASCII_FONT_COUNT) return 0;
    if (x < 0) return 0;
    if (x >= __ZENITH_LIBC_ASCII_FONT_WIDTH) return 0;
    if (y < 0) return 0;
    if (y >= __ZENITH_LIBC_ASCII_FONT_HEIGHT) return 0;

    row = __ZENITH_LIBC_ASCII_BITMAP[(c * __ZENITH_LIBC_ASCII_FONT_HEIGHT) + y];

    return (row >> (7 - x)) & 1;
}

uint16_t __zenith_libc_cursor_x = 0;
uint16_t __zenith_libc_cursor_y = 0;

void __zenith_libc_draw_ascii_char(char c) {
    unsigned char code = c;
    if (code >= __ZENITH_LIBC_ASCII_FONT_COUNT) {
        return;
    }

    int glyph_base = code * __ZENITH_LIBC_ASCII_FONT_HEIGHT;

    for (int gy = 0; gy < __ZENITH_LIBC_ASCII_FONT_HEIGHT; gy++) {
        unsigned char row = __ZENITH_LIBC_ASCII_BITMAP[glyph_base + gy];
        if (row == 0) {
            continue;
        }

        int pixel_y = __zenith_libc_cursor_y + (gy * __ZENITH_LIBC_FONT_SCALE);
        for (int gx = 0; gx < __ZENITH_LIBC_ASCII_FONT_WIDTH; gx++) {
            if ((row >> (7 - gx)) & 1) {
                int pixel_x = __zenith_libc_cursor_x + (gx * __ZENITH_LIBC_FONT_SCALE);
                for (int sy = 0; sy < __ZENITH_LIBC_FONT_SCALE; sy++) {
                    for (int sx = 0; sx < __ZENITH_LIBC_FONT_SCALE; sx++) {
                        __zenith_libc_put_white_pixel(pixel_x + sx, pixel_y + sy);
                    }
                }
            }
        }
    }
}

void __zenith_libc_erase_char() {
    for (int gy = 0; gy < __ZENITH_LIBC_CELL_HEIGHT; gy++) {
        for (int gx = 0; gx < __ZENITH_LIBC_CELL_WIDTH; gx++) {
            long pixel_offset = (((__zenith_libc_cursor_y + gy) * __ZENITH_LIBC_FB_WIDTH) + (__zenith_libc_cursor_x + gx)) * 3;
            unsigned char *pixel = __ZENITH_LIBC_FB_PIXEL_BASE + pixel_offset;

            pixel[0] = 0;
            pixel[1] = 0;
            pixel[2] = 0;
        }
    }
}

char __zenith_libc_int_to_char(int digit) {
    if (digit < 0) return '?';
    if (digit > 9) return '?';

    return '0' + digit;
}

void __zenith_libc_print_char(char c) {
    if (c == '\n') {
        __zenith_libc_cursor_x = 0;
        __zenith_libc_cursor_y = __zenith_libc_cursor_y + __ZENITH_LIBC_LINE_HEIGHT;
        return;
    }

    __zenith_libc_draw_ascii_char(c);
    __zenith_libc_cursor_x = __zenith_libc_cursor_x + __ZENITH_LIBC_CELL_WIDTH;
}

void __zenith_libc_print_int(int value) {
    char digits[12];
    int count = 0;

    if (value == 0) {
        __zenith_libc_print_char('0');
        return;
    }

    if (value < 0) {
        __zenith_libc_print_char('-');
        value = -value;
    }

    while (value > 0) {
        digits[count] = __zenith_libc_int_to_char(value % 10);
        value = value / 10;
        count = count + 1;
    }

    while (count > 0) {
        count = count - 1;
        __zenith_libc_print_char(digits[count]);
    }
}

/// @brief print characters to screen
/// @param word string to print
///
/// This `printf` works differently than the regular libc printf. Generally, libc's printf buffers text in memory,
/// and makes a write system call when flushed. This printf draws directly and instantly to the framebuffer. It is
/// significantly simpler than setting up system calls for printing, but significantly slower than modern machines as
/// it must slowly query and copy the relevant bitmap to the framebuffer. I have kept it this way for simplicity, but
/// in the future, it may be worth implementing a proper system call for writing to screen.
///
/// As a result of this design, users must always call [`enable_framebuffer`] before printing.
void printf(char *word) {
    while (*word) {
        if (*word == '\n') {
            __zenith_libc_cursor_x = 0;
            __zenith_libc_cursor_y = __zenith_libc_cursor_y + __ZENITH_LIBC_LINE_HEIGHT;
        } else if (*word == '\b') {
            __zenith_libc_cursor_x = __zenith_libc_cursor_x - __ZENITH_LIBC_CELL_WIDTH;
            __zenith_libc_erase_char(' ');
        } else {
            __zenith_libc_draw_ascii_char(*word);
            __zenith_libc_cursor_x = __zenith_libc_cursor_x + __ZENITH_LIBC_CELL_WIDTH;
        }
        ++word;
    }
}

/// @brief print integer to screen
/// @param word string to print
/// @param xs list of integers to print
///
/// Since Zenith C doesn't have varargs, we're unable to implement the usual integer substitution in printf. To work
/// around this, we can take an array of integers and use that as our "variable arguments". However, this would require
/// each `printf` call to provide at least a null pointer, which is annoying at best. So, when users would like to
/// print an integer with variable arguments, they should just call this function, leaving the regular printf
/// untouched.
void printf_ints(char* word, int* xs) {
    uint8_t i = 0;
    while (*word) {
        if (*word == '\n') {
            __zenith_libc_cursor_x = 0;
            __zenith_libc_cursor_y = __zenith_libc_cursor_y + __ZENITH_LIBC_LINE_HEIGHT;
        } else if (*word == '%') {
            ++word;
            if (*word == 'd') {
                __zenith_libc_print_int(xs[i]);
                ++i;
            }
        } else {
            __zenith_libc_draw_ascii_char(*word);
            __zenith_libc_cursor_x = __zenith_libc_cursor_x + __ZENITH_LIBC_CELL_WIDTH;
        }
        ++word;
    }
}

char hid_to_ascii(uint32_t key_code) {
    switch (key_code) {
    case 0x04: return 'a';
    case 0x05: return 'b';
    case 0x06: return 'c';
    case 0x07: return 'd';
    case 0x08: return 'e';
    case 0x09: return 'f';
    case 0x0A: return 'g';
    case 0x0B: return 'h';
    case 0x0C: return 'i';
    case 0x0D: return 'j';
    case 0x0E: return 'k';
    case 0x0F: return 'l';
    case 0x10: return 'm';
    case 0x11: return 'n';
    case 0x12: return 'o';
    case 0x13: return 'p';
    case 0x14: return 'q';
    case 0x15: return 'r';
    case 0x16: return 's';
    case 0x17: return 't';
    case 0x18: return 'u';
    case 0x19: return 'v';
    case 0x1A: return 'w';
    case 0x1B: return 'x';
    case 0x1C: return 'y';
    case 0x1D: return 'z';

    case 0x1E: return '1';
    case 0x1F: return '2';
    case 0x20: return '3';
    case 0x21: return '4';
    case 0x22: return '5';
    case 0x23: return '6';
    case 0x24: return '7';
    case 0x25: return '8';
    case 0x26: return '9';
    case 0x27: return '0';

    case 0x28: return '\n';
    case 0x2B: return '\t';
    case 0x2C: return ' ';
    case 0x2D: return '-';
    case 0x2E: return '=';
    case 0x2F: return '[';
    case 0x30: return ']';
    case 0x31: return '\\';
    case 0x33: return ';';
    case 0x34: return '\'';
    case 0x35: return '`';
    case 0x36: return ',';
    case 0x37: return '.';
    case 0x38: return '/';
    }

    return 0;
}

#define KEYBOARD_STATUS_CONTROL 0xFFFFFFFFFFA00000ULL
#define KEYBOARD_KEY_EVENT 0xFFFFFFFFFFA00004ULL
#define KEYBOARD_FIFO_COUNT 0xFFFFFFFFFFA00008ULL

void enable_keyboard() {
    uint32_t *control = KEYBOARD_STATUS_CONTROL;

    *control = 0x8;
}

/// @brief C-style scanf function to poll from the keyboard.
/// @param c reference to character buffer
///
/// Defaults to receiving characters, does not support other types. Note: the buffer should be large enough to store a
/// line. Otherwise is undefined behaviour.
void scanf(char* c) {
    uint32_t *control = KEYBOARD_STATUS_CONTROL;
    uint32_t *key_event = KEYBOARD_KEY_EVENT;
    uint16_t i = 0;

    while (1) {
        uint32_t status = *control;

        if (status & 0x1) {
            uint32_t event = *key_event;
            uint32_t key_code = event & 0xFFFF;
            uint32_t pressed = (event >> 16) & 1;

            if (key_code == 40) {
                // enter
                c[i] = 0;
                printf("\n");
                return;
            } else if (key_code == 42 && i > 0) {
                // backspace
                --i;
                printf("\b");
                continue;
            }

            if (pressed) {
                char ch = hid_to_ascii(key_code);
                if (ch) {
                    c[i] = ch;
                    char list[2] = {ch, 0};
                    printf(list);
                    ++i;
                }
            }
        }
    }
}
