kostareg/zenith/(commit log)

2026-05-20 docs: framebuffer
2026-05-20 chore: set up assembler
2026-05-20 test: assembler
2026-05-21 feat(web): assembly
2026-05-22 feat(emulator): framebuffer
2026-05-22 chore: migrate to zenith-assembler naming
2026-05-29 fix(hardware): use alu for pc increments
    [main.sv]
2026-05-29 feat(hardware): control flow instructions
2026-06-04 feat(assembler): generate zelf
2026-06-17 feat(web): instructions per frame graph
2026-06-17 feat(web): full screen framebuffer
2026-06-17 feat(libc): print newlines
2026-06-17 feat(libc): print integers
2026-07-13 feat(pcba): setup
    [BGA96_K4B4G1_SAM.step, CSCSG325_AMD.step, untitled.kicad_sch, zenith-pcba.kicad_pcb, zenith-pcba.kicad_sch]
2026-07-14 feat(pcba): initial programmer setup
    [programmer.kicad_sch, programmerrealkicad_sch.kicad_sch, todo.kicad_sch, todop.kicad_sch, untitled.kicad_sch, zenith-pcba.kicad_pcb, zenith-pcba.kicad_sch]
2026-07-14 feat(pcba): programmer connections and uart
    [programmerrealkicad_sch.kicad_sch, todo.kicad_sch, todop.kicad_sch, zenith-pcba.kicad_pcb]
2026-07-14 fix(pcba): 3d models
    [programmerrealkicad_sch.kicad_sch, zenith-pcba.kicad_pcb]
2026-07-14 chore(pcba): logo
    [zenith-pcba.kicad_pcb]
2026-07-15 fix(pcba): data routing
    [programmerrealkicad_sch.kicad_sch, zenith-pcba.kicad_pcb]
2026-07-15 feat(pcba): usb esd
    [programmerrealkicad_sch.kicad_sch, zenith-pcba.kicad_pcb]
2026-07-15 fix(pcba): usb c esd ground
    [programmerrealkicad_sch.kicad_sch, zenith-pcba.kicad_pcb]
2026-07-15 feat(pcba): 3.3v buck
    [programmerrealkicad_sch.kicad_sch, zenith-pcba.kicad_pcb]
2026-07-15 chore(pcba): labels
    [zenith-pcba.kicad_pcb]
2026-07-16 chore(pcba): import din connectors
    [programmerrealkicad_sch.kicad_sch, todo.kicad_sch, todop.kicad_sch, zenith-pcba.kicad_pcb]
2026-07-17 feat(pcba): din esd
    [todop.kicad_sch, zenith-pcba.kicad_pcb]
2026-07-17 fix(pcba): route ps2 esd
    [zenith-pcba.kicad_pcb]
2026-07-17 feat(pcba): sd card schematic
    [other.kicad_sch, todop.kicad_sch, zenith-pcba.kicad_pcb, zenith-pcba.kicad_sch]
2026-07-20 feat(pcba): migrate to kintex fpga
    [other.kicad_sch, programmerrealkicad_sch.kicad_sch, todo.kicad_sch, todop.kicad_sch, zenith-pcba.kicad_pcb]
2026-07-20 feat(pcba): pcb edge cuts
    [other.kicad_sch, todop.kicad_sch, zenith-pcba.kicad_pcb]
2026-07-20 feat(pcba): vga
    [todop.kicad_sch, zenith-pcba.kicad_pcb]
2026-07-20 feat(pcba): vga level shifter
    [todop.kicad_sch, zenith-pcba.kicad_pcb]
2026-07-21 chore(pcba): clean up pages
    [disconnected_io.kicad_sch, programmerrealkicad_sch.kicad_sch, todop.kicad_sch, zenith-pcba.kicad_pcb, zenith-pcba.kicad_sch]
2026-08-17 fix(web): fullscreen framebuffer and other peripherals together
2026-08-17 fix(web): optimize emulator output time
    [stdio.h]
2026-08-17 fix(web): type with framebuffer focused
    [main.c]
2026-08-18 feat(hardware): ddr3 sodimm import
    [disconnected_io.kicad_sch, todo.kicad_sch, zenith-pcba.kicad_pcb]
2026-08-18 chore(pcba): clean up unused files
2026-09-01 fix: scale up ASCII stdout
    [stdio.h]
